IowaScaledEngineering/mss-xcade/README.md

# mss-xcade
Modular Signal System 4 Port Complex Cascade
