IowaScaledEngineering/mss-xcade/kicad/mss-xcade/mss-xcade.ods

Item | Qty | Value | Unit Cost | Ttl Cost | Reference(s) | Description | Device | Digi-Key_PN | Family | MPN | Manufacturer | Status | Voltage
1 | 28 | 0.1uF |  | 0 | C1, C9, C11, C13, C17, C18, C19, C20, C21, C22, C23, C24, C25, C26, C27, C28, C29, C30, C31, C32, C33, C34, C35, C36, C37, C38, C39, C40 |  |  |  |  |  |  |  | 16V
2 | 3 | 1uF |  | 0 | C2, C8, C10 |  |  |  |  |  |  |  | 6.3V
3 | 4 | 22uF |  | 0 | C3, C4, C5, C15 |  |  |  |  |  |  |  | 6.3V
4 | 1 | 68uF |  | 0 | C6
5 | 4 | 10uF |  | 0 | C7, C12, C14, C16 |  |  |  |  |  |  |  | 25V
6 | 5 | CDBM140G | 0.07 | 0.35 | D1, D2, D5, D6, D8
7 | 3 | GREEN LED | 0.05 | 0.15 | D3, D4, D12
8 | 2 | AMBER | 0.05 | 0.1 | D7, D10
9 | 1 | WS2812B | 0.25 | 0.25 | D9
10 | 1 | CDBM140G | 0.07 | 0.07 | D11
12 | 1 | Screw_Terminal_01x02 |  | 0 | J1
13 | 12 | Screw_Terminal_01x02 |  | 0 | J2, J3, J4, J5, J6, J7, J8, J9, J10, J12, J13, J14
14 | 1 | 690-005-299-043 | 0.4 | 0.4 | J11 | CONN RCPT USB2.0 MINI B SMD R/A |  | 151-1206-1-ND | USB, DVI, HDMI Connectors | 690-005-299-043 | EDAC Inc. | Active
15 | 13 | SM04B-SRSS | 0.12 | 1.56 | J15, J16, J17, J18, J19, J20, J21, J22, J23, J24, J25, J26, J27
16 | 1 | Screw_Terminal_01x08 |  | 0 | J28
17 | 4 | 8P8C |  | 0 | J29, J30, J31, J32
18 | 24 | SolderJumper_2_Open |  | 0 | JP1, JP2, JP3, JP4, JP5, JP6, JP7, JP8, JP9, JP10, JP11, JP12, JP13, JP14, JP15, JP16, JP17, JP18, JP19, JP20, JP21, JP22, JP23, JP24
19 | 4 | SolderJumper_2_Bridged |  | 0 | JP25, JP26, JP27, JP28
20 | 2 | 4.7uH | 0.775 | 1.55 | L1, L2 |  | MSS6132-472
21 | 2 | BSS138 | 0.06 | 0.12 | Q1, Q2
22 | 16 | ZXMS6004FF | 0.31 | 4.96 | Q3, Q4, Q5, Q6, Q7, Q8, Q9, Q10, Q11, Q12, Q13, Q14, Q15, Q16, Q17, Q18
23 | 25 | 330 | 0.01 | 0.25 | R1, R4, R5, R6, R7, R8, R9, R11, R14, R19, R20, R22, R23, R24, R25, R26, R27, R28, R29, R30, R31, R32, R33, R35, R51
24 | 15 | 1k | 0.01 | 0.15 | R2, R3, R12, R13, R15, R16, R21, R34, R36, R39, R46, R54, R55, R56, R57
25 | 37 | 10k | 0.01 | 0.37 | R10, R17, R18, R37, R38, R40, R41, R42, R43, R44, R45, R47, R48, R49, R50, R52, R53, R58, R59, R60, R61, R62, R63, R64, R65, R66, R67, R68, R69, R70, R71, R72, R73, R74, R75, R76, R77
26 | 1 | FSM4JSMATR | 0.22 | 0.22 | SW1 | SWITCH TACTILE SPST-NO 0.05A 24V |  | 450-1759-1-ND | Tactile Switches | FSM4JSMATR | TE Connectivity ALCOSWITCH Switches | Active
27 | 2 | SW_DIP_x08 |  | 0 | SW2, SW3
29 | 1 | AZ1117-3.3 | 0.21 | 0.21 | U1
30 | 1 | AP63205WU | 0.58 | 0.58 | U2
31 | 2 | PCA9635 | 2.09 | 4.18 | U3, U6
32 | 1 | ESP32-S2-SOLO | 2.6 | 2.6 | U4
33 | 1 | PCA9548APW | 0.9 | 0.9 | U5
34 | 3 | PCA9555D | 1.15 | 3.45 | U7, U13, U16
35 | 1 | R05C1TF05S-R | 1.83 | 1.83 | U8
36 | 1 | AP3012 | 0.26 | 0.26 | U9
37 | 4 | 74HC4049 | 0.27 | 1.08 | U10, U11, U14, U15
38 | 1 | ISO1641 | 2.32 | 2.32 | U12
 |  |  |  | 27.91
Option B
 | 1 | attiny88 | 1.08 | 1.08
 | 2 | 74HC4049 | 0.27 | 0.54
 | 1 | AP63205WU | 0.58 | 0.58
 | 4 | DPDT signal relay | 1.43 | 5.72
 |  |  |  | 7.92
