IowaScaledEngineering/mss-xcade/pg/mss-xcade-v1.1-e1d36c9/mss-xcade.pdf

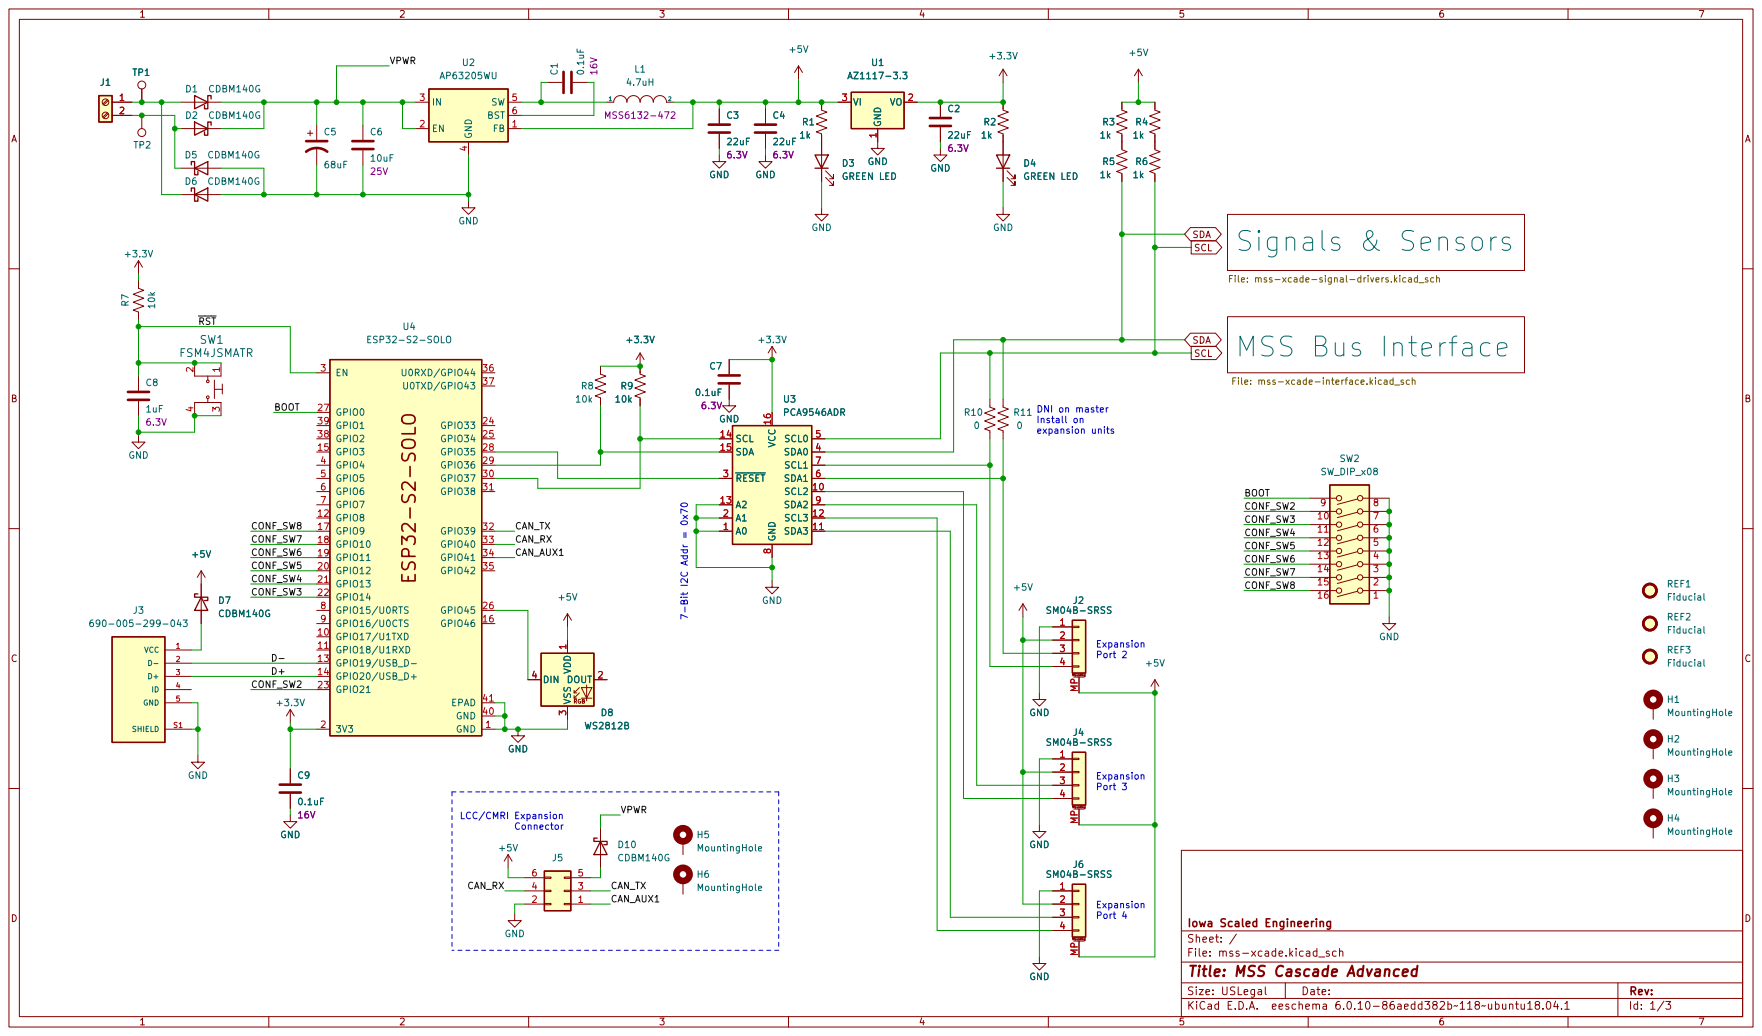
[picture p1: page 1]

File: mss-xcade-signal-drivers.kicad_sch R6

File: mss-xcade-interface.kicad_sch Signals & Sensors

Install on expansion units

VPWR

Iowa Scaled Engineering
File: mss-xcade.kicad_sch Sheet: /
Id: 1/3 Title: MSS Cascade Advanced

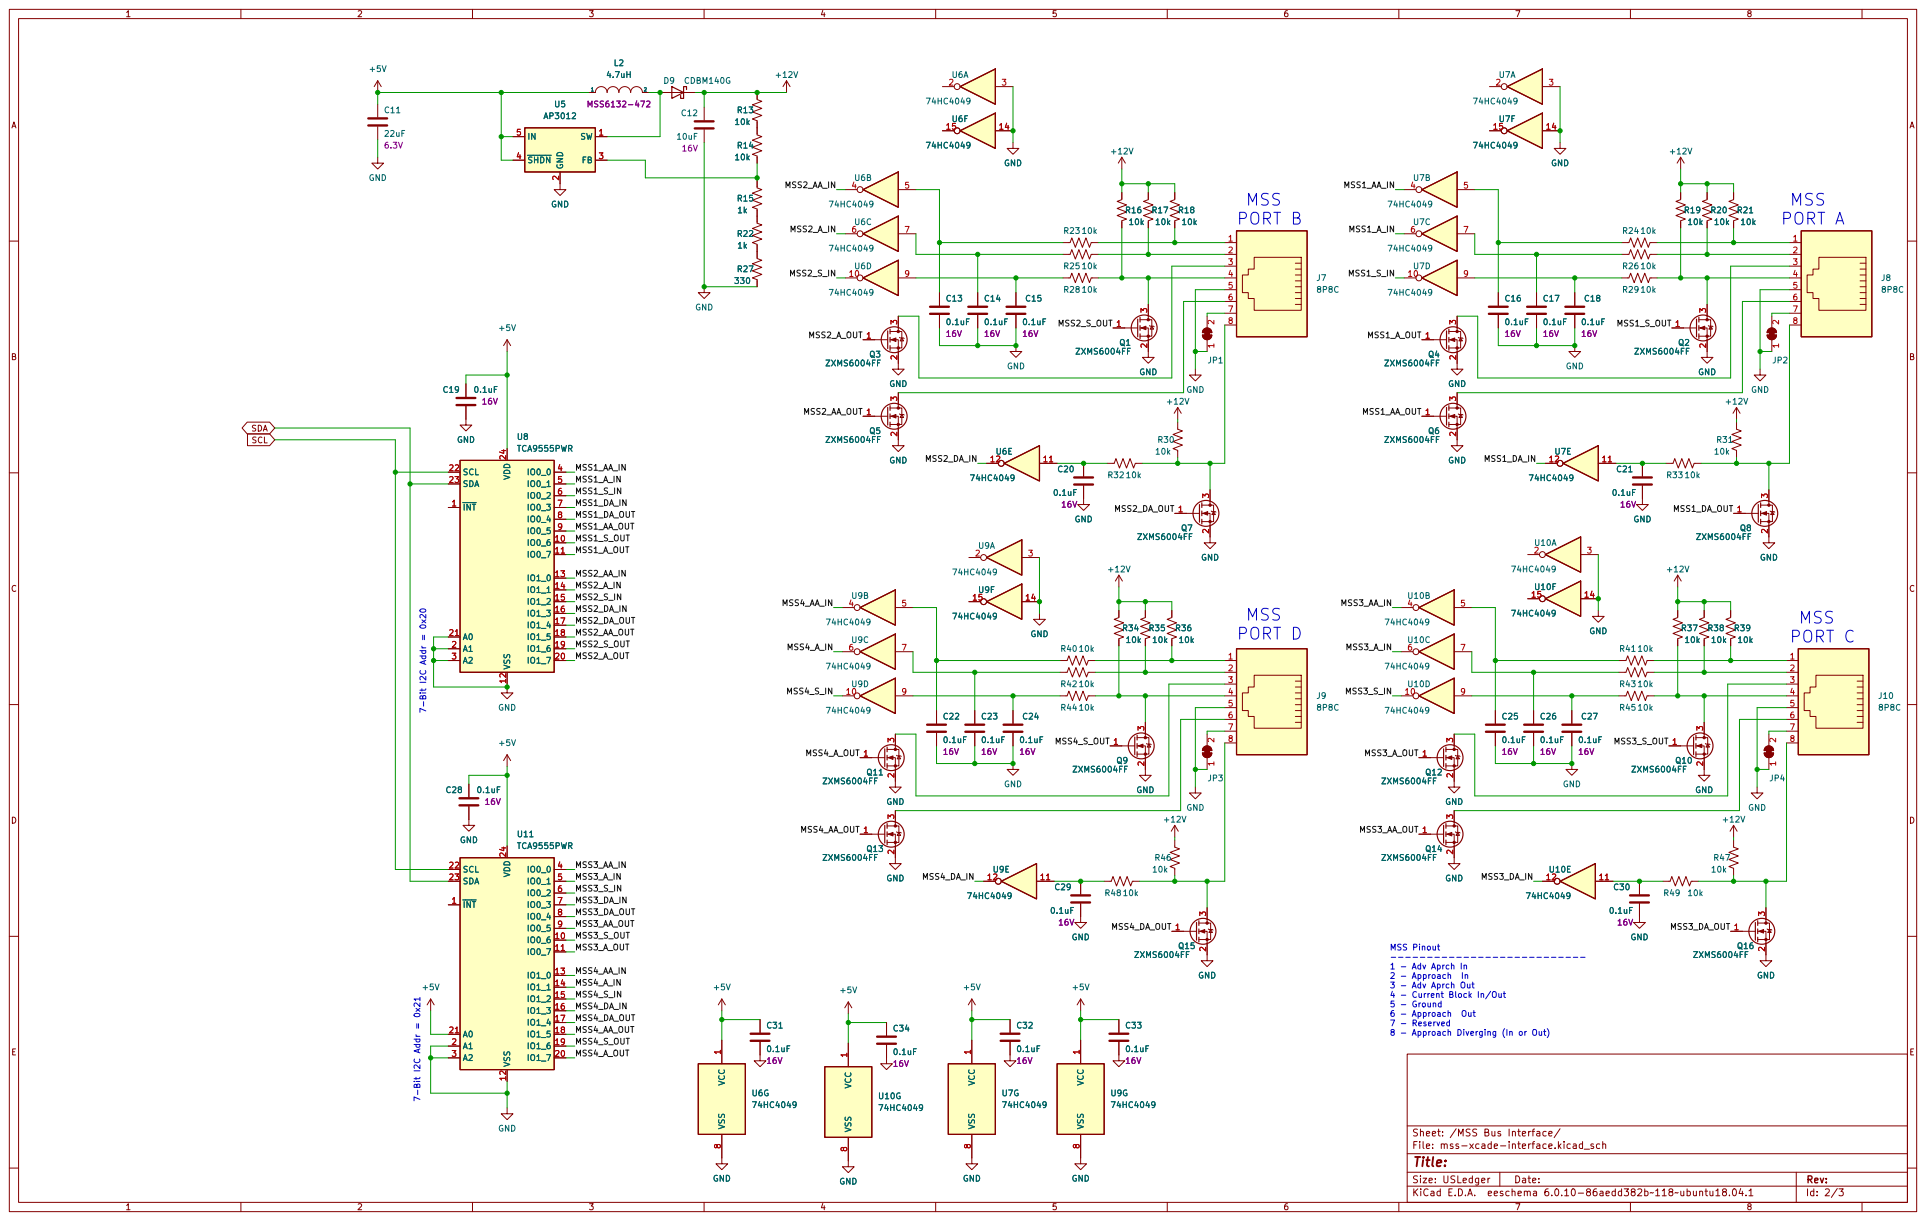
[picture p2: page 2]

MSS Pinout --------------------------- 1 - Adv Aprch In

2 - Approach In
3 - Adv Aprch Out 4 - Current Block In/Out 5 - Ground

8 - Approach Diverging (In or Out)

File: mss-xcade-interface.kicad_sch Sheet: /MSS Bus Interface/

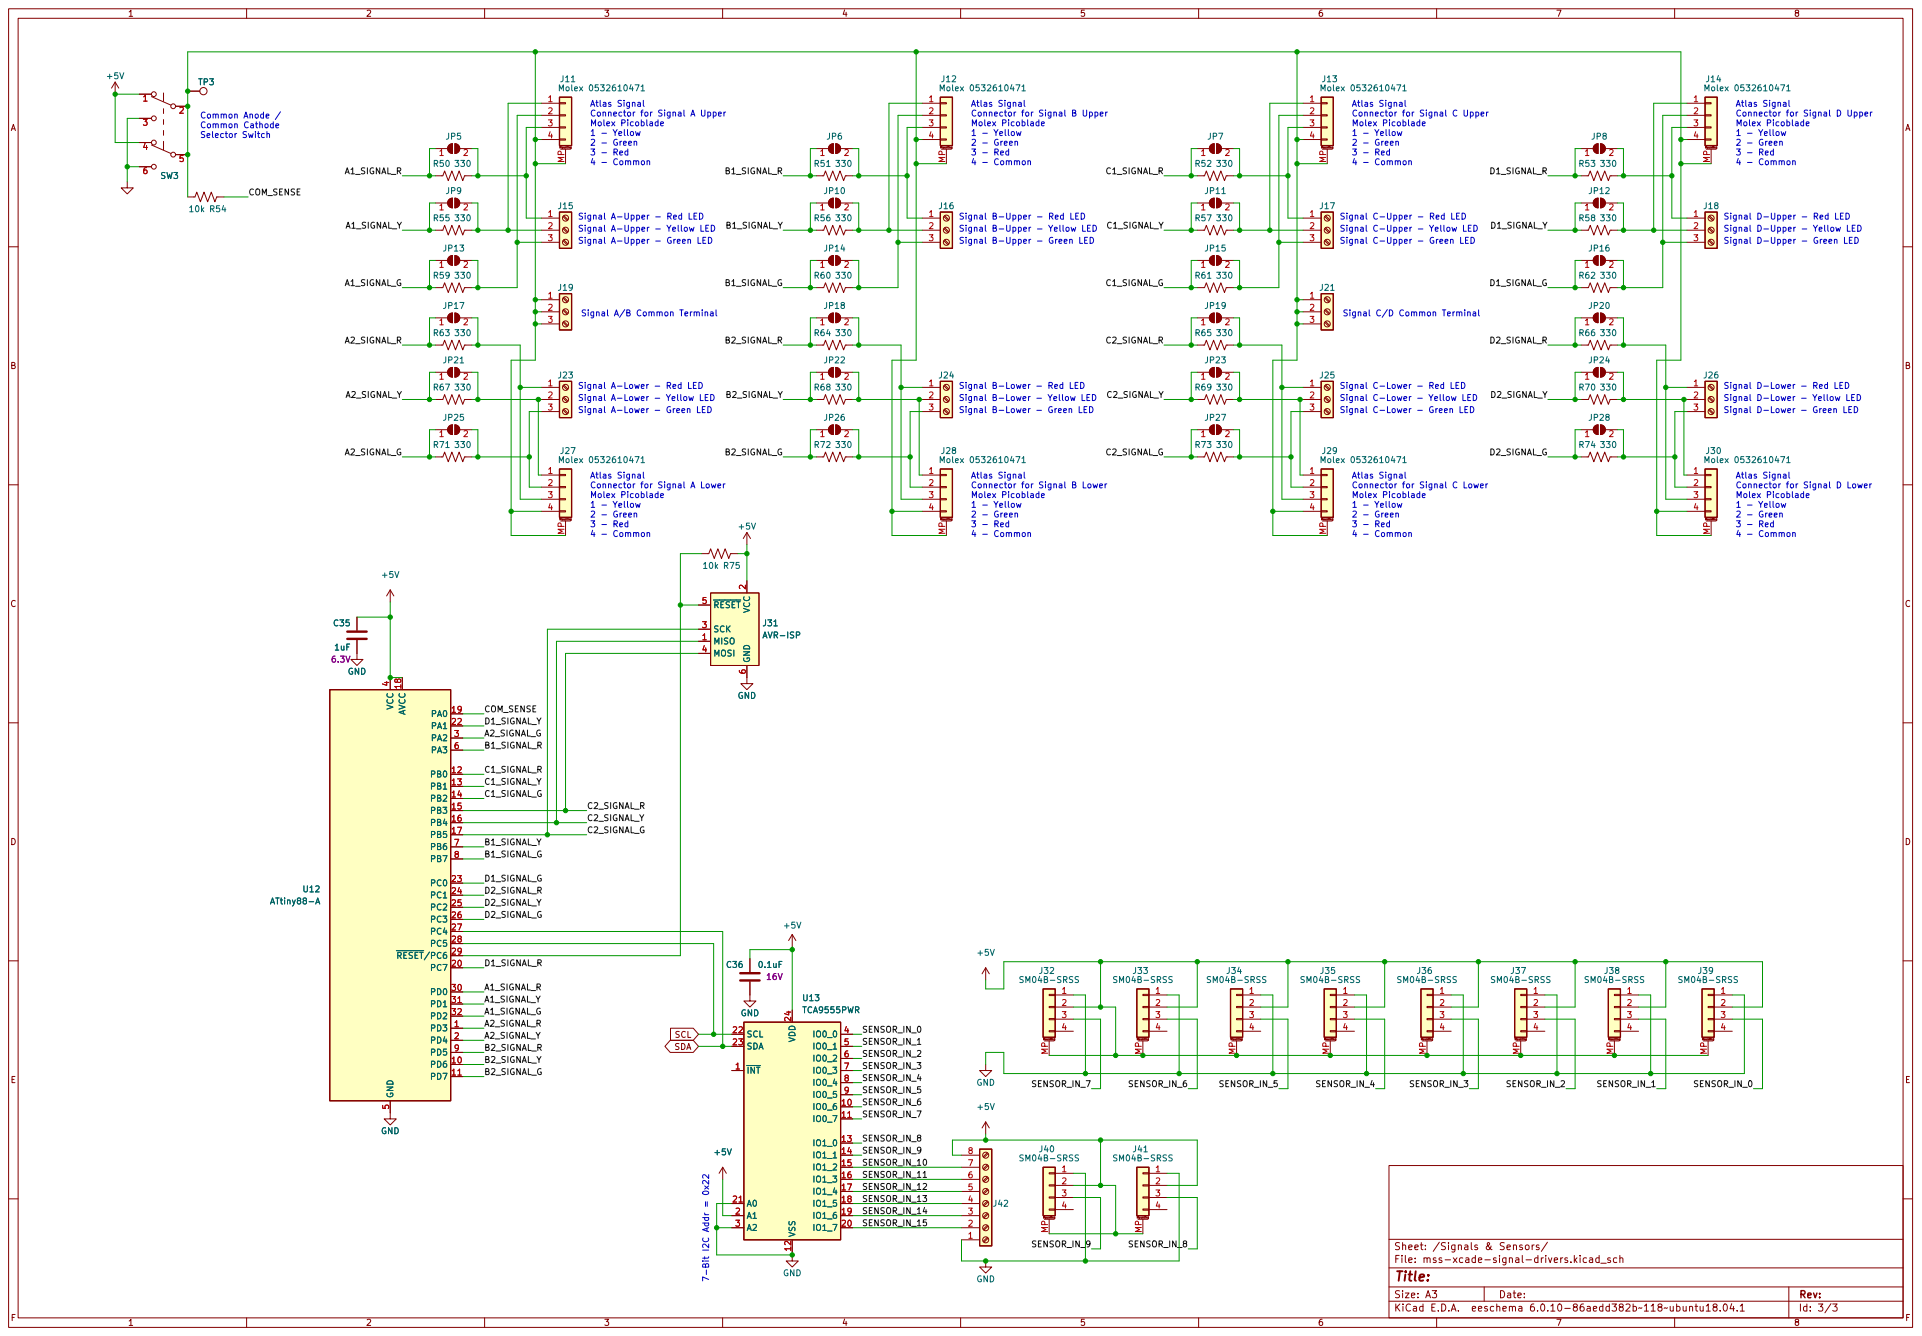
[picture p3: page 3]

Atlas Signal
Connector for Signal A Upper Molex Picoblade

Connector for Signal B Upper Molex Picoblade

Connector for Signal C Upper Molex Picoblade

Connector for Signal D Upper Molex Picoblade

1 - Yellow
2 - Green
3 - Red
4 - Common Signal C-Upper - Green LED

4 - Common Signal D-Upper - Red LED

Signal D-Lower - Red LED 7-Bit I2C Addr = 0x22

Connector for Signal B Lower Molex Picoblade

Connector for Signal C Lower Molex Picoblade

Connector for Signal D Lower Molex Picoblade

Connector for Signal A Lower Molex Picoblade

2 SCK 3 MOSI 4 ~{RESET} 5 GND

Sheet: /Signals & Sensors/
File: mss-xcade-signal-drivers.kicad_sch
Id: 3/3 Title:
