IowaScaledEngineering/mss-xcade/pg/mss-xcade-can-v1.0-1d90998/mss-xcade-can.pdf

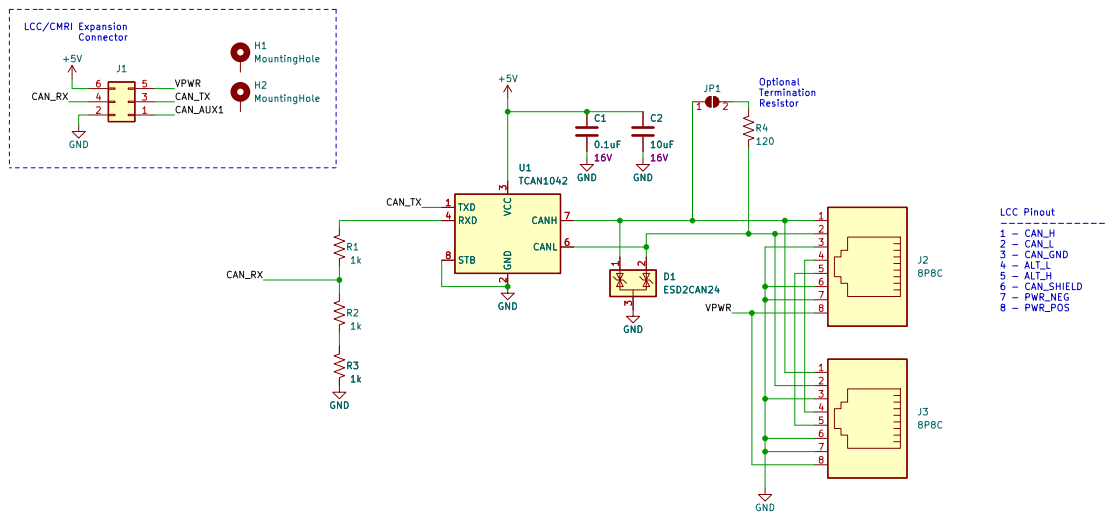
[picture p4: page 1]

3 RXD 4 CANL 6 CANH 7 STB 8 C1

3 RXD 4 CANL 6 CANH 7 STB 8 U1TCAN1042 GND

Iowa Scaled Engineering
File: mss-xcade-can.kicad_sch Sheet: /
Id: 1/1 Title: MSS Cascade Advanced CAN Board
