IowaScaledEngineering/mss-xcade/kicad/mss-xcade/mss-xcade.kicad_pcb

## KiCad design kicad/mss-xcade/mss-xcade.kicad_pcb (2025-08-19)

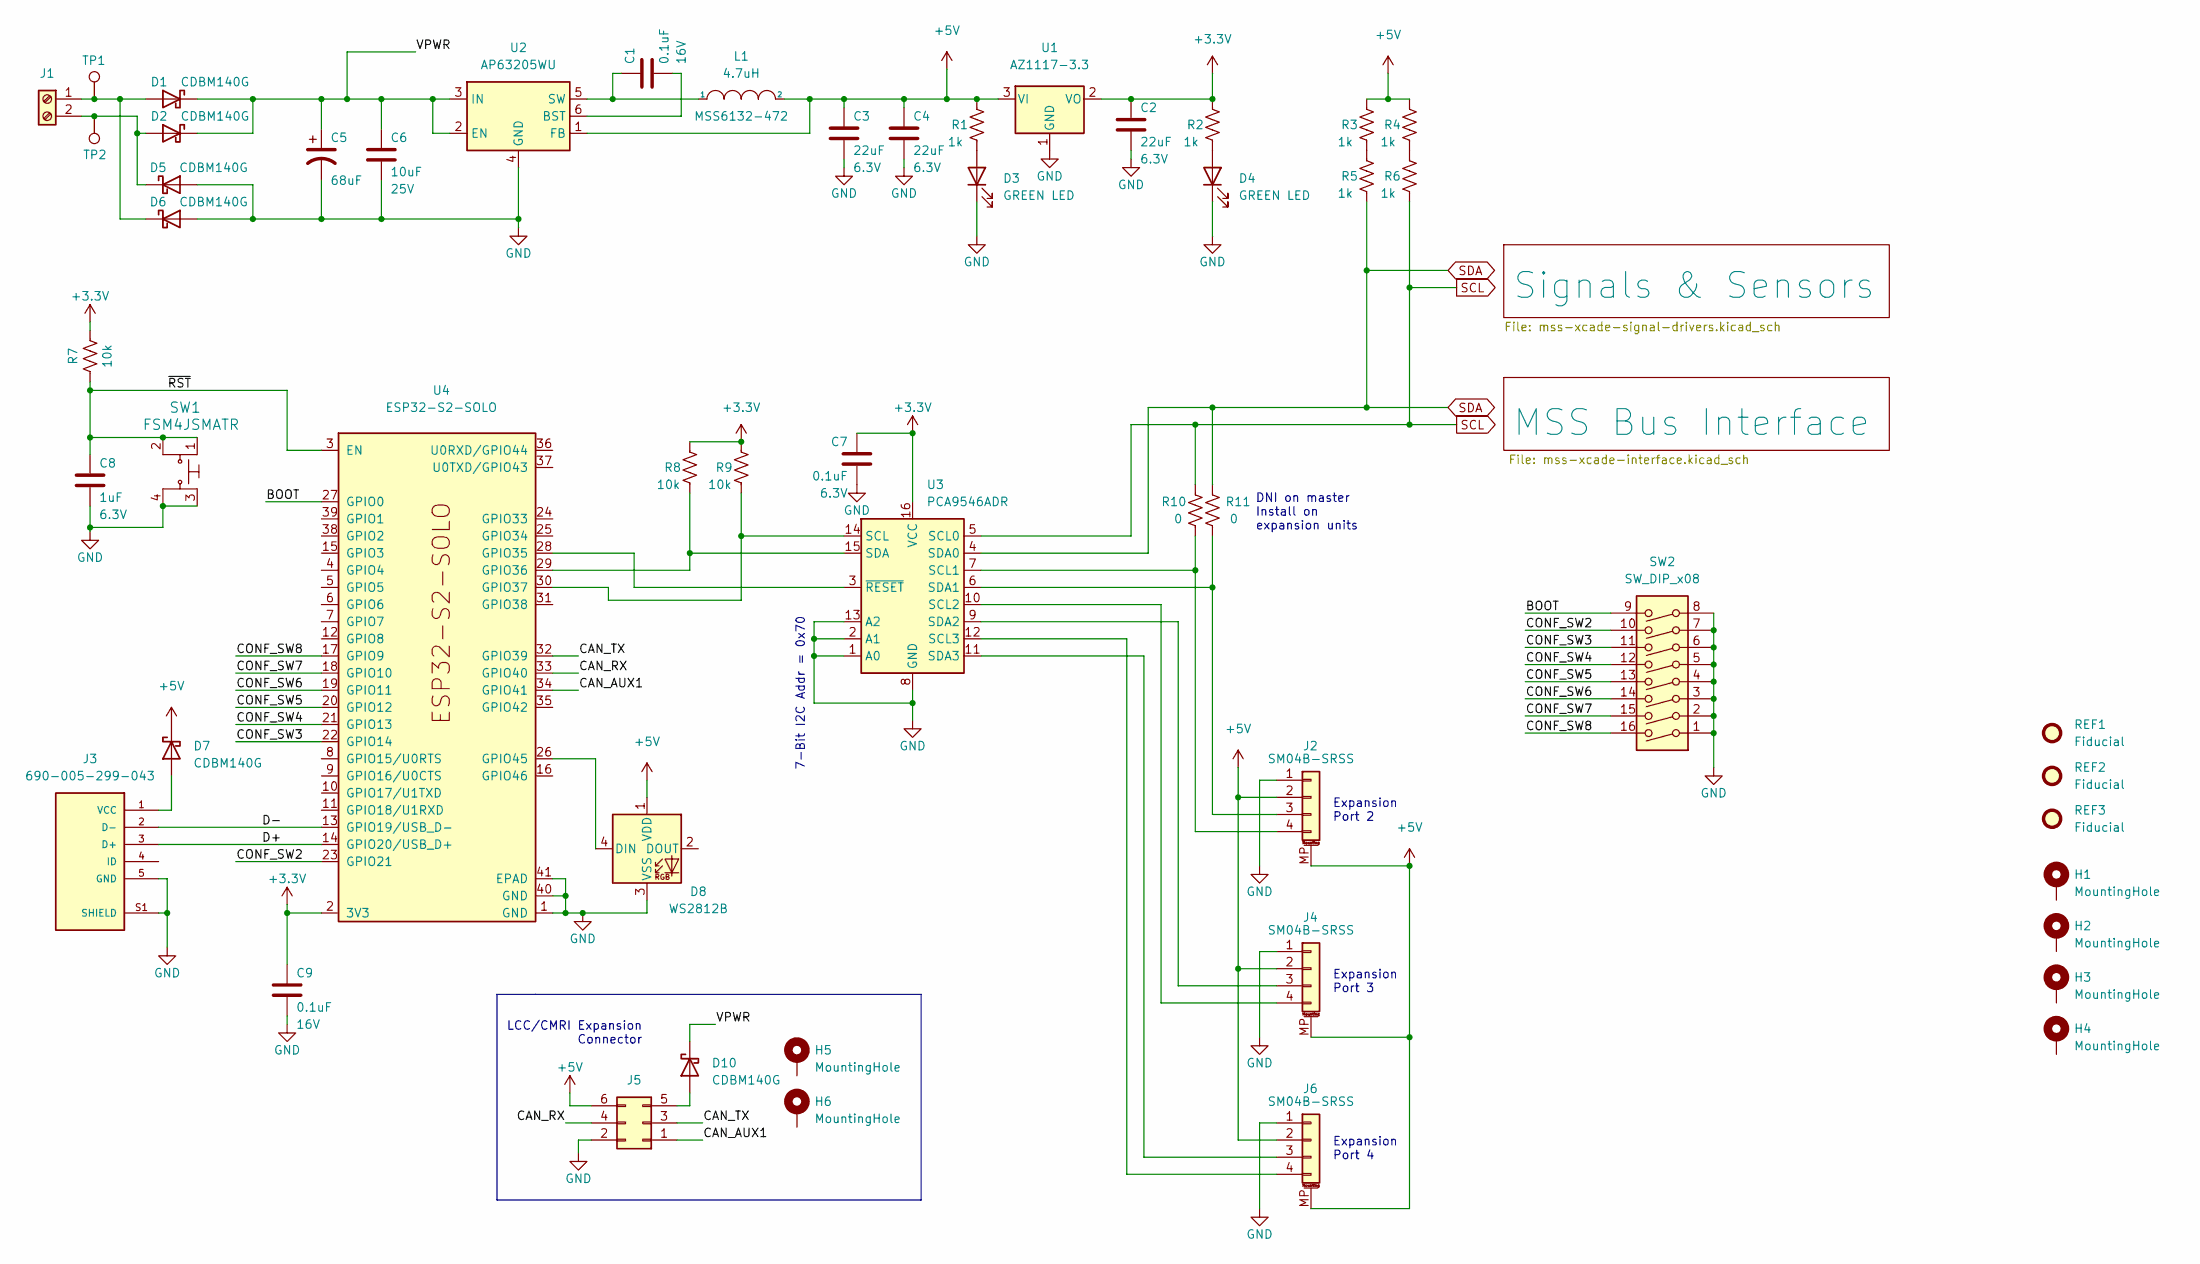
[picture p5: schematic mss-xcade.kicad_sch, MSS Cascade Advanced]

Parts:
C1, C9: 0.1uF; C_0805_2012Metric; Voltage 16V
C2, C3, C4: 22uF; C_0805_2012Metric; Voltage 6.3V
C5: 68uF; CP_Elec_6.3x5.8
C6: 10uF; C_0805_2012Metric; Voltage 25V
C7: 0.1uF; C_0805_2012Metric; Voltage 6.3V
C8: 1uF; C_0805_2012Metric; Voltage 6.3V
D1, D2, D5, D6, D7, D10: CDBM140G; SOD-123T
D3, D4: GREEN LED; LED_0805_2012Metric
D8: WS2812B; LED_WS2812B_PLCC4_5.0x5.0mm_P3.2mm
H1, H2, H3, H4: MountingHole; MountingHole_3.2mm_M3_Pad
H5, H6: MountingHole; MountingHole_3.2mm_M3_ISO14580_Pad
J1: Screw_Terminal_01x02; TerminalBlock_RND_205-00012_1x02_P5.00mm_Horizontal
J2, J4, J6: SM04B-SRSS; JST_SH_SM04B-SRSS-TB_1x04-1MP_P1.00mm_Horizontal
J3: 690-005-299-043; EDAC_690-005-299-043; PARTREV 11
J5: Conn_02x03_Odd_Even; PinHeader_2x03_P2.54mm_Vertical
L1: 4.7uH; MSS6132-xxxMLC
R1, R2, R3, R4, R5, R6: 1k; R_0805_2012Metric
R7, R8, R9: 10k; R_0805_2012Metric
R10, R11: 0; R_0805_2012Metric
REF1, REF2, REF3: Fiducial
SW1: FSM4JSMATR; TE_FSM4JSMA; MPN FSM4JSMATR; Digi-Key_PN 450-1759-1-ND
SW2: SW_DIP_x08; SW_DIP_SPSTx08_Slide_6.7x21.88mm_W8.61mm_P2.54mm_LowProfile
TP1, TP2: TestPoint; TestPoint_Pad_D2.0mm
U1: AZ1117-3.3; SOT-223-3_TabPin2
U2: AP63205WU; TSOT-23-6
U3: PCA9546ADR; SOIC-16_3.9x9.9mm_P1.27mm
U4: ESP32-S2-SOLO

Connections:
+3.3V: C2.1, C7.1, C9.1, R2.2, R7.2, R8.2, R9.2, U1.2 (VO), U3.16 (VCC), U4.2 (3V3)
+5V: C3.1, C4.1, D7.1 (K), D8.1 (VDD), J2.2, J2.MP (MountPin), J4.2, J4.MP (MountPin), J5.6, J6.2, J6.MP (MountPin), L1.2, R1.2, R3.2, R4.2, U1.3 (VI), U2.1 (FB); also elsewhere on the board
/BOOT: SW2.9, U4.27 (GPIO0)
/CAN_AUX1: J5.1, U4.34 (GPIO41)
/CAN_RX: J5.4, U4.33 (GPIO40)
/CAN_TX: J5.3, U4.32 (GPIO39)
/CONF_SW2: SW2.10, U4.23 (GPIO21)
/CONF_SW3: SW2.11, U4.22 (GPIO14)
/CONF_SW4: SW2.12, U4.21 (GPIO13)
/CONF_SW5: SW2.13, U4.20 (GPIO12)
/CONF_SW6: SW2.14, U4.19 (GPIO11)
/CONF_SW7: SW2.15, U4.18 (GPIO10)
/CONF_SW8: SW2.16, U4.17 (GPIO9)
/D+: J3.3 (D+), U4.14 (GPIO20/USB_D+)
/D-: J3.2 (D-), U4.13 (GPIO19/USB_D-)
/VPWR: C5.1, C6.1, D1.1 (K), D2.1 (K), D10.1 (K), U2.2 (EN), U2.3 (IN)
/~RST: C8.1, R7.1, SW1.1, SW1.2, U4.3 (EN)
GND: C2.2, C3.2, C4.2, C5.2, C6.2, C7.2, C8.2, C9.2, D3.1 (K), D4.1 (K), D5.2 (A), D6.2 (A), D8.3 (VSS), J2.1, J3.5 (GND), J3.S1 (SHIELD), J4.1, J5.2, J6.1, SW1.3, SW1.4, SW2.1, SW2.2, SW2.3, SW2.4, SW2.5, SW2.6, SW2.7, SW2.8, U1.1 (GND), U2.4 (GND), U3.1 (A0), U3.2 (A1), U3.8 (GND), U3.13 (A2), U4.1 (GND), U4.40 (GND), U4.41 (EPAD); also elsewhere on the board
unnamed: C1.1, L1.1, U2.5 (SW)
unnamed: C1.2, U2.6 (BST)
unnamed: D1.2 (A), D6.1 (K), J1.1, TP1.1
unnamed: D2.2 (A), D5.1 (K), J1.2, TP2.1
unnamed: D3.2 (A), R1.1
unnamed: D4.2 (A), R2.1
unnamed: D7.2 (A), J3.1 (VCC)
unnamed: D8.4 (DIN), U4.26 (GPIO45)
unnamed: D10.2 (A), J5.5
unnamed: J2.3, R11.1, U3.6 (SDA1)
unnamed: J2.4, R10.1, U3.7 (SCL1)
unnamed: J4.3, U3.9 (SDA2)
unnamed: J4.4, U3.10 (SCL2)
unnamed: J6.3, U3.11 (SDA3)
unnamed: J6.4, U3.12 (SCL3)
unnamed: R3.1, R5.2
unnamed: R4.1, R6.2
unnamed: R8.1, U3.15 (SDA), U4.29 (GPIO36)
unnamed: R9.1, U3.14 (SCL), U4.30 (GPIO37)
unnamed: U3.3 (~RESET), U4.28 (GPIO35)
SCL: R6.1, R10.2, U3.5 (SCL0); also elsewhere on the board
SDA: R5.1, R11.2, U3.4 (SDA0); also elsewhere on the board

Notes on the sheet:
LCC/CMRI Expansion Connector
Expansion Port 2
Expansion Port 4
DNI on master Install on expansion units
7-Bit I2C Addr = 0x70
Expansion Port 3

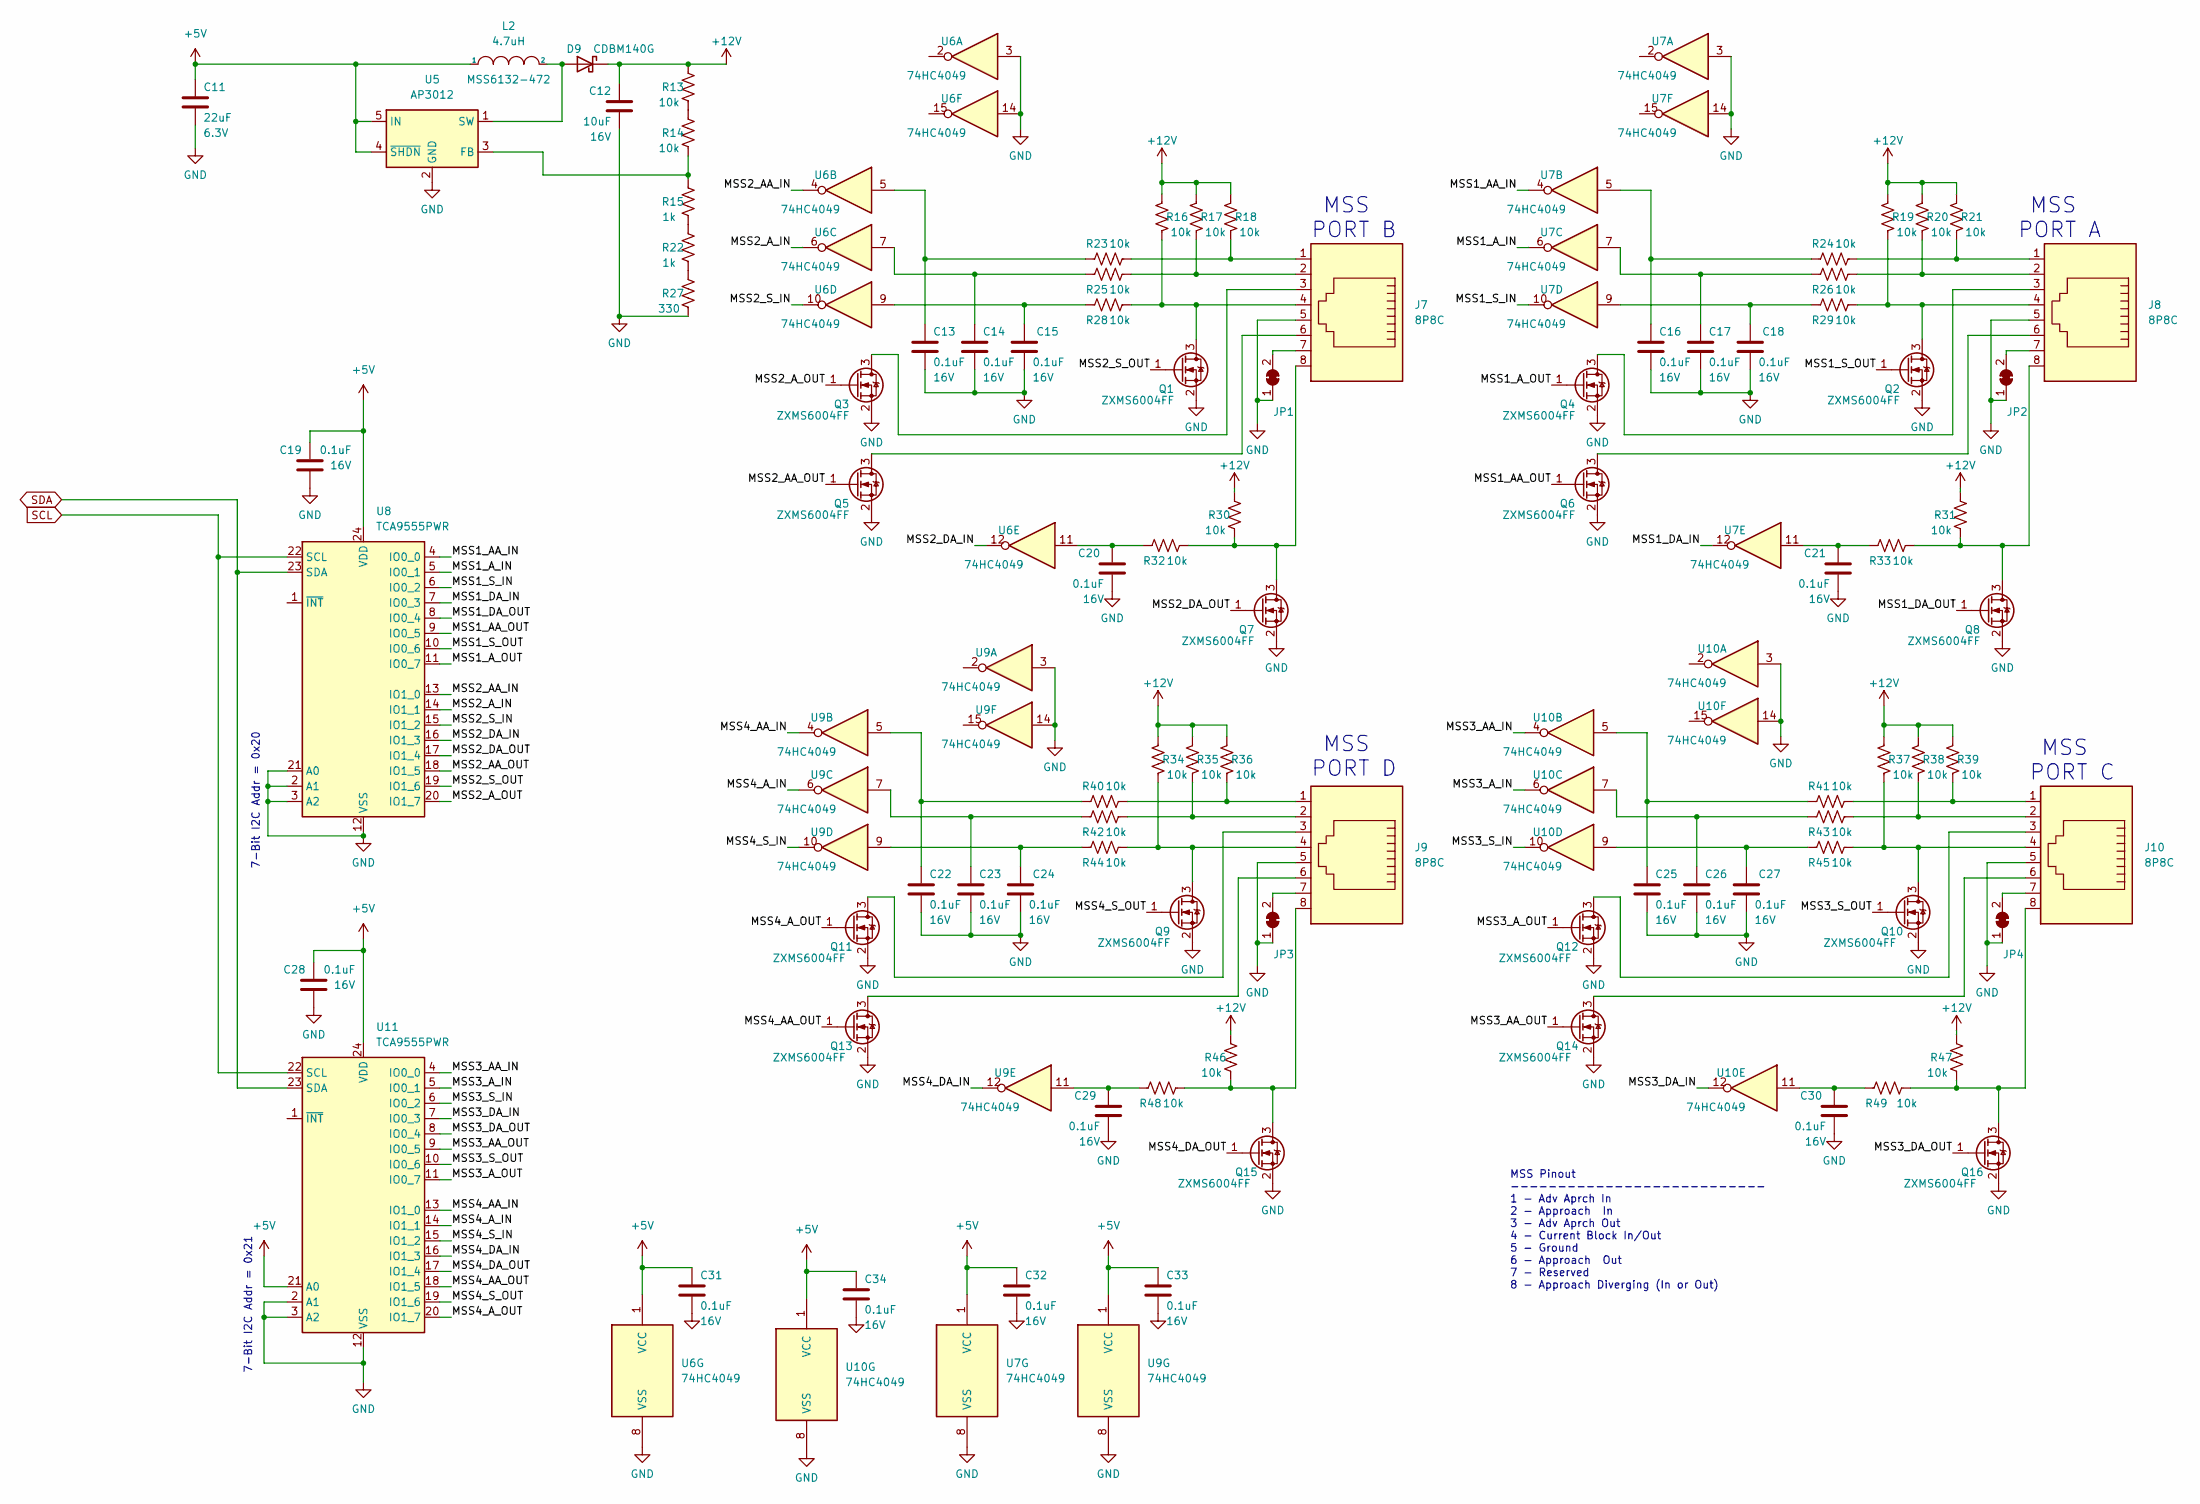
[picture p6: schematic mss-xcade-interface.kicad_sch]

Parts:
C11: 22uF; C_0805_2012Metric; Voltage 6.3V
C12: 10uF; C_0805_2012Metric; Voltage 16V
C13, C14, C15, C16, C17, C18, C19, C20, C21, C22, C23, C24, C25, C26, C27, C28, C29, C30, C31, C32, C33, C34: 0.1uF; C_0805_2012Metric; Voltage 16V
D9: CDBM140G; SOD-123T
J7, J8, J9, J10: 8P8C; RJ45_Amphenol_54602-x08_Horizontal
JP1, JP2, JP3, JP4: SolderJumper_2_Bridged; SolderJumper-2_P1.3mm_Bridged_RoundedPad1.0x1.5mm
L2: 4.7uH; MSS6132-xxxMLC
Q1, Q2, Q3, Q4, Q5, Q6, Q7, Q8, Q9, Q10, Q11, Q12, Q13, Q14, Q15, Q16: ZXMS6004FF; SOT-23
R13, R14, R16, R17, R18, R19, R20, R21, R23, R24, R25, R26, R28, R29, R30, R31, R32, R33, R34, R35, R36, R37, R38, R39, R40, R41, R42, R43, R44, R45, R46, R47, R48, R49: 10k; R_0805_2012Metric
R15, R22: 1k; R_0805_2012Metric
R27: 330; R_0805_2012Metric
U5: AP3012; SOT-23-5
U6, U7, U9, U10: 74HC4049; SO-16_3.9x9.9mm_P1.27mm
U8, U11: TCA9555PWR; TSSOP-24_4.4x7.8mm_P0.65mm

Connections:
+5V: C11.1, C19.1, C28.1, C31.1, C32.1, C33.1, C34.1, L2.1, U5.4 (~SHDN), U5.5 (IN), U6.1 (VCC), U7.1 (VCC), U8.24 (VDD), U9.1 (VCC), U10.1 (VCC), U11.21 (A0), U11.24 (VDD); also elsewhere on the board
+12V: C12.1, D9.1 (K), R13.2, R16.2, R17.2, R18.2, R19.2, R20.2, R21.2, R30.2, R31.2, R34.2, R35.2, R36.2, R37.2, R38.2, R39.2, R46.2, R47.2
/MSS Bus Interface/MSS1_AA_IN: U7.4, U8.4 (IO0_0)
/MSS Bus Interface/MSS1_AA_OUT: Q6.1 (G), U8.9 (IO0_5)
/MSS Bus Interface/MSS1_A_IN: U7.6, U8.5 (IO0_1)
/MSS Bus Interface/MSS1_A_OUT: Q4.1 (G), U8.11 (IO0_7)
/MSS Bus Interface/MSS1_DA_IN: U7.12, U8.7 (IO0_3)
/MSS Bus Interface/MSS1_DA_OUT: Q8.1 (G), U8.8 (IO0_4)
/MSS Bus Interface/MSS1_S_IN: U7.10, U8.6 (IO0_2)
/MSS Bus Interface/MSS1_S_OUT: Q2.1 (G), U8.10 (IO0_6)
/MSS Bus Interface/MSS2_AA_IN: U6.4, U8.13 (IO1_0)
/MSS Bus Interface/MSS2_AA_OUT: Q5.1 (G), U8.18 (IO1_5)
/MSS Bus Interface/MSS2_A_IN: U6.6, U8.14 (IO1_1)
/MSS Bus Interface/MSS2_A_OUT: Q3.1 (G), U8.20 (IO1_7)
/MSS Bus Interface/MSS2_DA_IN: U6.12, U8.16 (IO1_3)
/MSS Bus Interface/MSS2_DA_OUT: Q7.1 (G), U8.17 (IO1_4)
/MSS Bus Interface/MSS2_S_IN: U6.10, U8.15 (IO1_2)
/MSS Bus Interface/MSS2_S_OUT: Q1.1 (G), U8.19 (IO1_6)
/MSS Bus Interface/MSS3_AA_IN: U10.4, U11.4 (IO0_0)
/MSS Bus Interface/MSS3_AA_OUT: Q14.1 (G), U11.9 (IO0_5)
/MSS Bus Interface/MSS3_A_IN: U10.6, U11.5 (IO0_1)
/MSS Bus Interface/MSS3_A_OUT: Q12.1 (G), U11.11 (IO0_7)
/MSS Bus Interface/MSS3_DA_IN: U10.12, U11.7 (IO0_3)
/MSS Bus Interface/MSS3_DA_OUT: Q16.1 (G), U11.8 (IO0_4)
/MSS Bus Interface/MSS3_S_IN: U10.10, U11.6 (IO0_2)
/MSS Bus Interface/MSS3_S_OUT: Q10.1 (G), U11.10 (IO0_6)
/MSS Bus Interface/MSS4_AA_IN: U9.4, U11.13 (IO1_0)
/MSS Bus Interface/MSS4_AA_OUT: Q13.1 (G), U11.18 (IO1_5)
/MSS Bus Interface/MSS4_A_IN: U9.6, U11.14 (IO1_1)
/MSS Bus Interface/MSS4_A_OUT: Q11.1 (G), U11.20 (IO1_7)
/MSS Bus Interface/MSS4_DA_IN: U9.12, U11.16 (IO1_3)
/MSS Bus Interface/MSS4_DA_OUT: Q15.1 (G), U11.17 (IO1_4)
/MSS Bus Interface/MSS4_S_IN: U9.10, U11.15 (IO1_2)
/MSS Bus Interface/MSS4_S_OUT: Q9.1 (G), U11.19 (IO1_6)
GND: C11.2, C12.2, C13.2, C14.2, C15.2, C16.2, C17.2, C18.2, C19.2, C20.2, C21.2, C22.2, C23.2, C24.2, C25.2, C26.2, C27.2, C28.2, C29.2, C30.2, C31.2, C32.2, C33.2, C34.2, J7.5, J8.5, J9.5, J10.5, JP1.1 (A), JP2.1 (A), JP3.1 (A), JP4.1 (A), Q1.2 (S), Q2.2 (S), Q3.2 (S), Q4.2 (S), Q5.2 (S), Q6.2 (S), Q7.2 (S), Q8.2 (S), Q9.2 (S), Q10.2 (S), Q11.2 (S), Q12.2 (S), Q13.2 (S), Q14.2 (S), Q15.2 (S), Q16.2 (S), R27.1, U5.2 (GND), U6.3, U6.8 (VSS), U6.14, U7.3, U7.8 (VSS), U7.14, U8.2 (A1), U8.3 (A2), U8.12 (VSS), U8.21 (A0), U9.3, U9.8 (VSS), U9.14, U10.3, U10.8 (VSS), U10.14, U11.2 (A1), U11.3 (A2), U11.12 (VSS); also elsewhere on the board
unnamed: C13.1, R23.2, U6.5
unnamed: C14.1, R25.2, U6.7
unnamed: C15.1, R28.2, U6.9
unnamed: C16.1, R24.2, U7.5
unnamed: C17.1, R26.2, U7.7
unnamed: C18.1, R29.2, U7.9
unnamed: C20.1, R32.2, U6.11
unnamed: C21.1, R33.2, U7.11
unnamed: C22.1, R40.2, U9.5
unnamed: C23.1, R42.2, U9.7
unnamed: C24.1, R44.2, U9.9
unnamed: C25.1, R41.2, U10.5
unnamed: C26.1, R43.2, U10.7
unnamed: C27.1, R45.2, U10.9
unnamed: C29.1, R48.2, U9.11
unnamed: C30.1, R49.2, U10.11
unnamed: D9.2 (A), L2.2, U5.1 (SW)
unnamed: J7.1, R18.1, R23.1
unnamed: J7.2, R17.1, R25.1
unnamed: J7.3, Q3.3 (D)
unnamed: J7.4, Q1.3 (D), R16.1, R28.1
unnamed: J7.6, Q5.3 (D)
unnamed: J7.7, JP1.2 (B)
unnamed: J7.8, Q7.3 (D), R30.1, R32.1
unnamed: J8.1, R21.1, R24.1
unnamed: J8.2, R20.1, R26.1
unnamed: J8.3, Q4.3 (D)
unnamed: J8.4, Q2.3 (D), R19.1, R29.1
unnamed: J8.6, Q6.3 (D)
unnamed: J8.7, JP2.2 (B)
unnamed: J8.8, Q8.3 (D), R31.1, R33.1
unnamed: J9.1, R36.1, R40.1
unnamed: J9.2, R35.1, R42.1
unnamed: J9.3, Q11.3 (D)
unnamed: J9.4, Q9.3 (D), R34.1, R44.1
unnamed: J9.6, Q13.3 (D)
unnamed: J9.7, JP3.2 (B)
unnamed: J9.8, Q15.3 (D), R46.1, R48.1
unnamed: J10.1, R39.1, R41.1
unnamed: J10.2, R38.1, R43.1
unnamed: J10.3, Q12.3 (D)
unnamed: J10.4, Q10.3 (D), R37.1, R45.1
unnamed: J10.6, Q14.3 (D)
unnamed: J10.7, JP4.2 (B)
unnamed: J10.8, Q16.3 (D), R47.1, R49.1
unnamed: R13.1, R14.2
unnamed: R14.1, R15.2, U5.3 (FB)
unnamed: R15.1, R22.2
unnamed: R22.1, R27.2
SCL: U8.22 (SCL), U11.22 (SCL); also elsewhere on the board
SDA: U8.23 (SDA), U11.23 (SDA); also elsewhere on the board

Notes on the sheet:
MSS PORT A
7-Bit I2C Addr = 0x20
MSS Pinout --------------------------- 1 - Adv Aprch In 2 - Approach In 3 - Adv Aprch Out 4 - Current Block In/Out 5 - Ground 6 - Approach Out 7 - Reserved 8 - Approach Diverging (In or Out)
7-Bit I2C Addr = 0x21
MSS PORT B
MSS PORT D
MSS PORT C

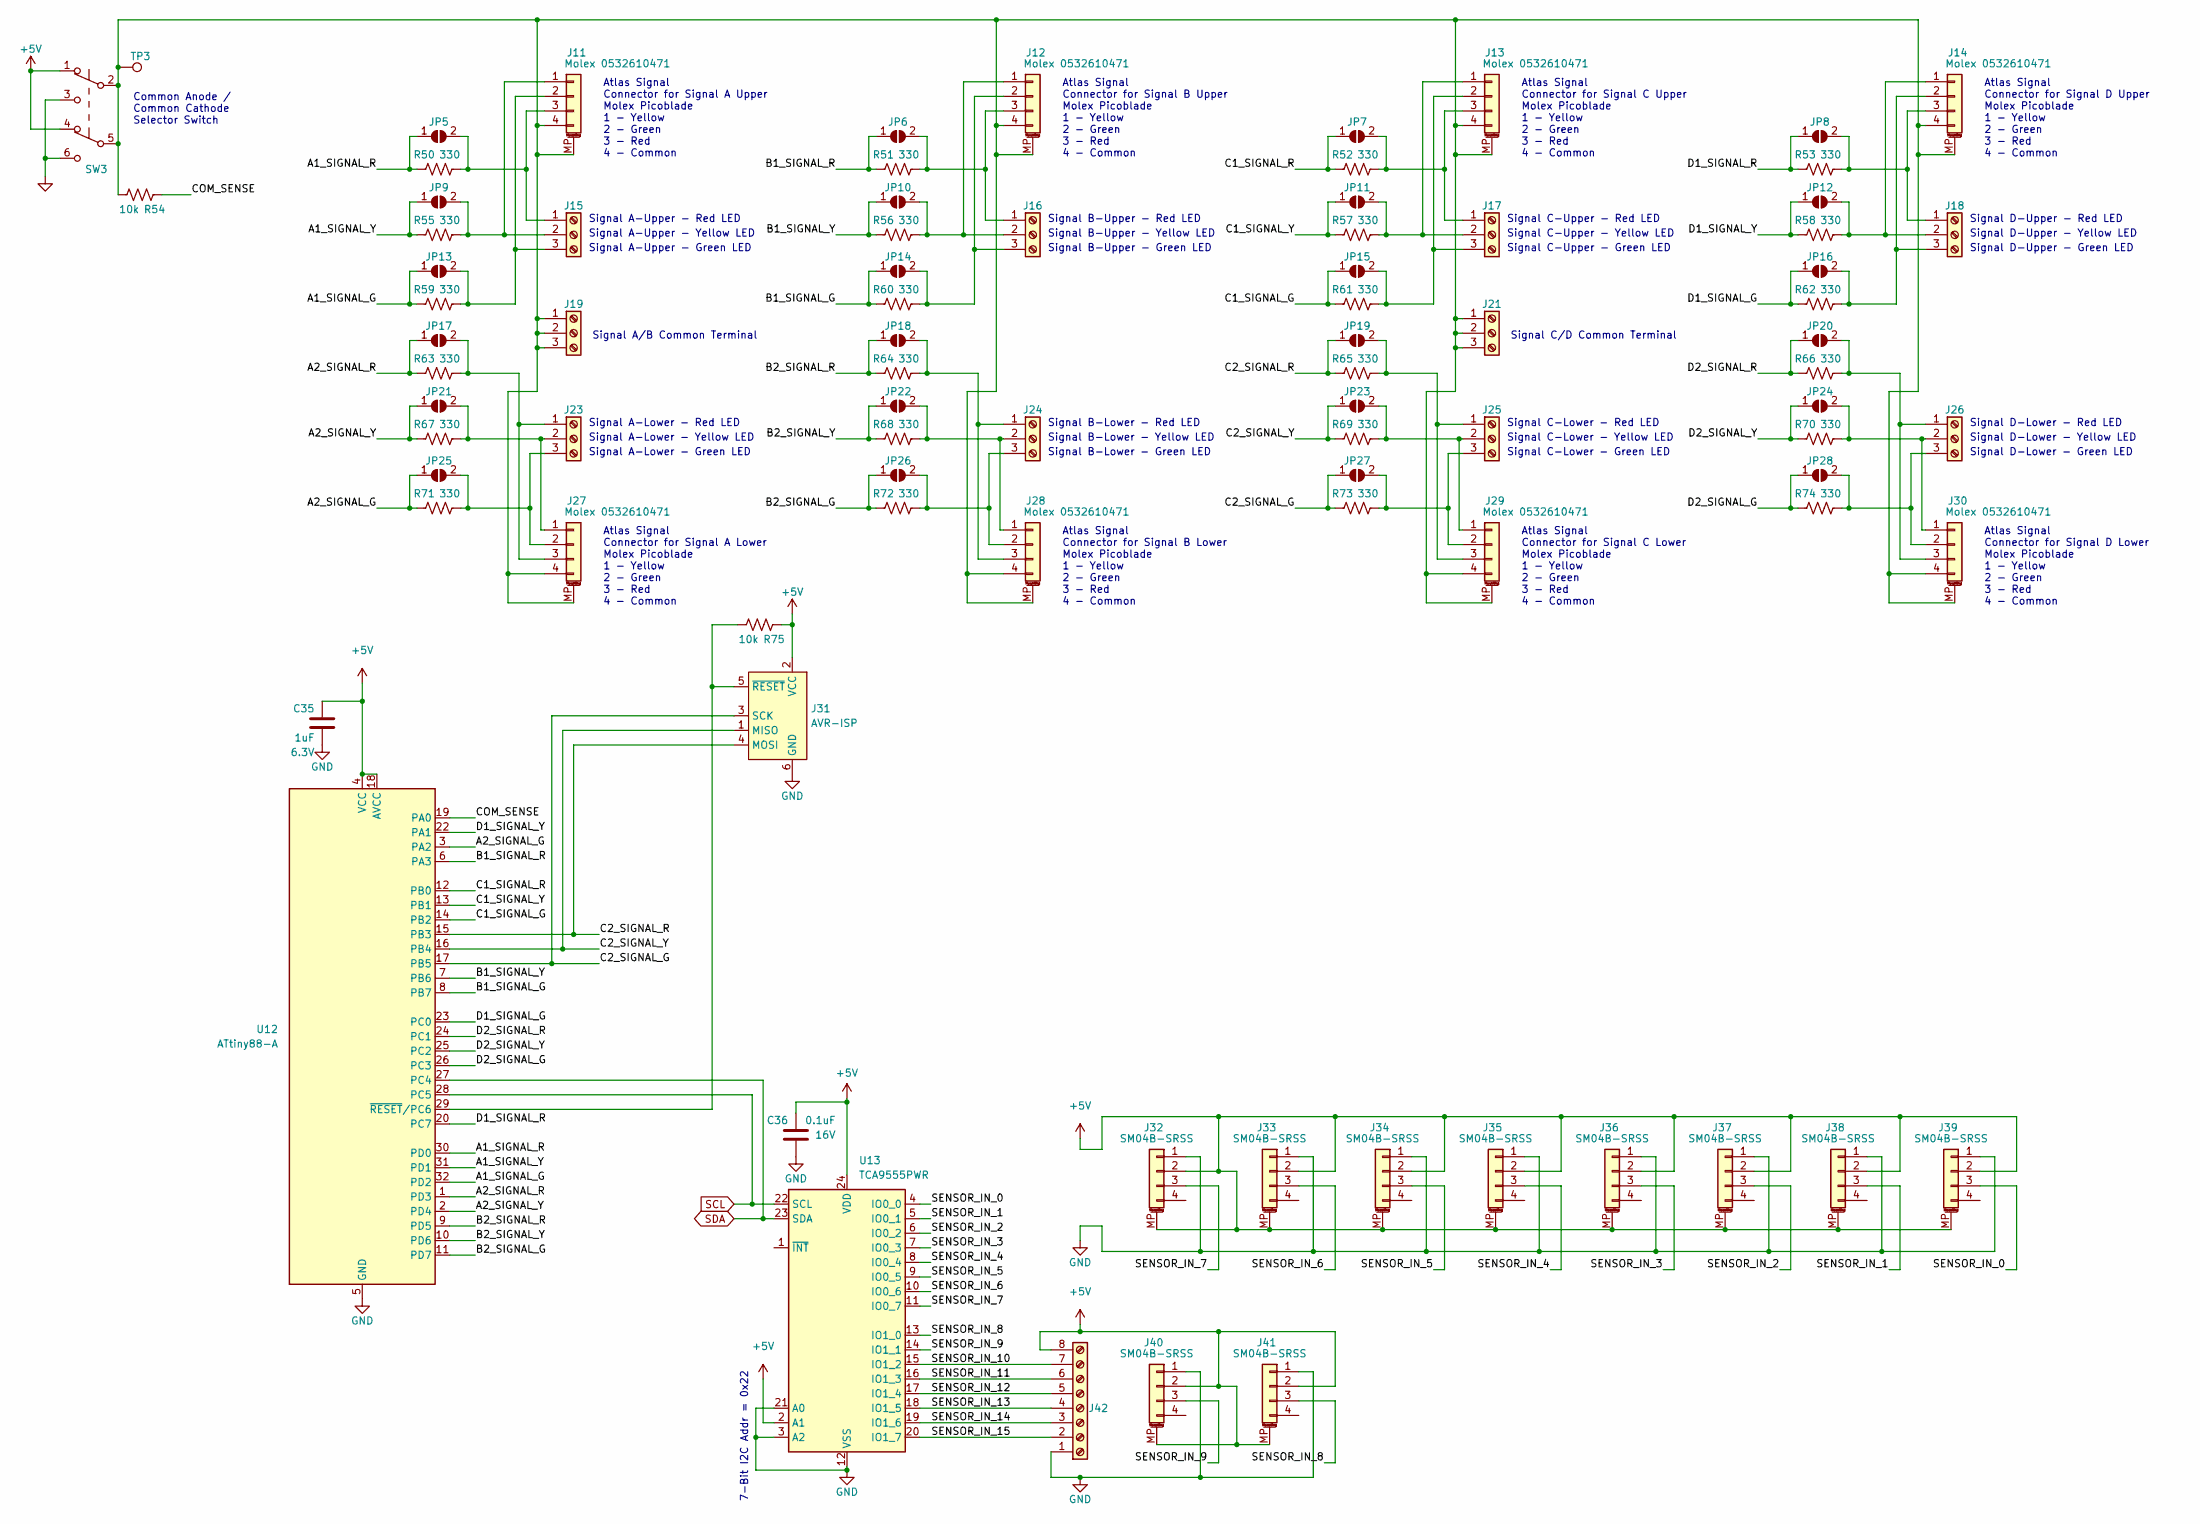
[picture p7: schematic mss-xcade-signal-drivers.kicad_sch]

Parts:
C35: 1uF; C_0805_2012Metric; Voltage 6.3V
C36: 0.1uF; C_0805_2012Metric; Voltage 16V
J11, J12, J13, J14, J27, J28, J29, J30: Molex 0532610471; Molex_PicoBlade_53261-0471_1x04-1MP_P1.25mm_Horizontal
J15, J16, J17, J18, J19, J21, J23, J24, J25, J26: Screw_Terminal_01x02; TerminalBlock_MetzConnect_Type059_RT06303HBWC_1x03_P3.50mm_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
J31: AVR-ISP; Tag-Connect_TC2030-IDC-NL_2x03_P1.27mm_Vertical
J32, J33, J34, J35, J36, J37, J38, J39, J40, J41: SM04B-SRSS; JST_SH_SM04B-SRSS-TB_1x04-1MP_P1.00mm_Horizontal
J42: Screw_Terminal_01x08; TerminalBlock_TE_282834-8_1x08_P2.54mm_Horizontal
JP5, JP6, JP7, JP8, JP9, JP10, JP11, JP12, JP13, JP14, JP15, JP16, JP17, JP18, JP19, JP20, JP21, JP22, JP23, JP24, JP25, JP26, JP27, JP28: SolderJumper_2_Open; SolderJumper-2_P1.3mm_Open_RoundedPad1.0x1.5mm
R50, R51, R52, R53, R55, R56, R57, R58, R59, R60, R61, R62, R63, R64, R65, R66, R67, R68, R69, R70, R71, R72, R73, R74: 330; R_0805_2012Metric
R54, R75: 10k; R_0805_2012Metric
SW3: JS202011SCQN; SW_JS202011SCQN
TP3: TestPoint; TestPoint_Pad_D2.0mm
U12: ATtiny88-A; TQFP-32_7x7mm_P0.8mm
U13: TCA9555PWR; TSSOP-24_4.4x7.8mm_P0.65mm

Connections:
+5V: C35.1, C36.1, J31.2 (VCC), J32.2, J32.MP (MountPin), J33.2, J33.MP (MountPin), J34.2, J34.MP (MountPin), J35.2, J35.MP (MountPin), J36.2, J36.MP (MountPin), J37.2, J37.MP (MountPin), J38.2, J38.MP (MountPin), J39.2, J39.MP (MountPin), J40.2, J40.MP (MountPin), J41.2, J41.MP (MountPin), J42.8, R75.1, SW3.1 (A), SW3.4 (A), U12.4 (VCC), U12.18 (AVCC), U13.2 (A1), U13.24 (VDD); also elsewhere on the board
/Signals & Sensors/A1_SIGNAL_G: JP13.1 (A), R59.1, U12.32 (PD2)
/Signals & Sensors/A1_SIGNAL_R: JP5.1 (A), R50.1, U12.30 (PD0)
/Signals & Sensors/A1_SIGNAL_Y: JP9.1 (A), R55.1, U12.31 (PD1)
/Signals & Sensors/A2_SIGNAL_G: JP25.1 (A), R71.1, U12.3 (PA2)
/Signals & Sensors/A2_SIGNAL_R: JP17.1 (A), R63.1, U12.1 (PD3)
/Signals & Sensors/A2_SIGNAL_Y: JP21.1 (A), R67.1, U12.2 (PD4)
/Signals & Sensors/B1_SIGNAL_G: JP14.1 (A), R60.1, U12.8 (PB7)
/Signals & Sensors/B1_SIGNAL_R: JP6.1 (A), R51.1, U12.6 (PA3)
/Signals & Sensors/B1_SIGNAL_Y: JP10.1 (A), R56.1, U12.7 (PB6)
/Signals & Sensors/B2_SIGNAL_G: JP26.1 (A), R72.1, U12.11 (PD7)
/Signals & Sensors/B2_SIGNAL_R: JP18.1 (A), R64.1, U12.9 (PD5)
/Signals & Sensors/B2_SIGNAL_Y: JP22.1 (A), R68.1, U12.10 (PD6)
/Signals & Sensors/C1_SIGNAL_G: JP15.1 (A), R61.1, U12.14 (PB2)
/Signals & Sensors/C1_SIGNAL_R: JP7.1 (A), R52.1, U12.12 (PB0)
/Signals & Sensors/C1_SIGNAL_Y: JP11.1 (A), R57.1, U12.13 (PB1)
/Signals & Sensors/C2_SIGNAL_G: J31.3 (SCK), JP27.1 (A), R73.1, U12.17 (PB5)
/Signals & Sensors/C2_SIGNAL_R: J31.4 (MOSI), JP19.1 (A), R65.1, U12.15 (PB3)
/Signals & Sensors/C2_SIGNAL_Y: J31.1 (MISO), JP23.1 (A), R69.1, U12.16 (PB4)
/Signals & Sensors/COM_SENSE: R54.1, U12.19 (PA0)
/Signals & Sensors/D1_SIGNAL_G: JP16.1 (A), R62.1, U12.23 (PC0)
/Signals & Sensors/D1_SIGNAL_R: JP8.1 (A), R53.1, U12.20 (PC7)
/Signals & Sensors/D1_SIGNAL_Y: JP12.1 (A), R58.1, U12.22 (PA1)
/Signals & Sensors/D2_SIGNAL_G: JP28.1 (A), R74.1, U12.26 (PC3)
/Signals & Sensors/D2_SIGNAL_R: JP20.1 (A), R66.1, U12.24 (PC1)
/Signals & Sensors/D2_SIGNAL_Y: JP24.1 (A), R70.1, U12.25 (PC2)
/Signals & Sensors/SENSOR_IN_0: J39.3, U13.4 (IO0_0)
/Signals & Sensors/SENSOR_IN_1: J38.3, U13.5 (IO0_1)
/Signals & Sensors/SENSOR_IN_2: J37.3, U13.6 (IO0_2)
/Signals & Sensors/SENSOR_IN_3: J36.3, U13.7 (IO0_3)
/Signals & Sensors/SENSOR_IN_4: J35.3, U13.8 (IO0_4)
/Signals & Sensors/SENSOR_IN_5: J34.3, U13.9 (IO0_5)
/Signals & Sensors/SENSOR_IN_6: J33.3, U13.10 (IO0_6)
/Signals & Sensors/SENSOR_IN_7: J32.3, U13.11 (IO0_7)
/Signals & Sensors/SENSOR_IN_8: J41.3, U13.13 (IO1_0)
/Signals & Sensors/SENSOR_IN_9: J40.3, U13.14 (IO1_1)
/Signals & Sensors/SENSOR_IN_10: J42.7, U13.15 (IO1_2)
/Signals & Sensors/SENSOR_IN_11: J42.6, U13.16 (IO1_3)
/Signals & Sensors/SENSOR_IN_12: J42.5, U13.17 (IO1_4)
/Signals & Sensors/SENSOR_IN_13: J42.4, U13.18 (IO1_5)
/Signals & Sensors/SENSOR_IN_14: J42.3, U13.19 (IO1_6)
/Signals & Sensors/SENSOR_IN_15: J42.2, U13.20 (IO1_7)
GND: C35.2, C36.2, J31.6 (GND), J32.1, J33.1, J34.1, J35.1, J36.1, J37.1, J38.1, J39.1, J40.1, J41.1, J42.1, SW3.3 (C), SW3.6 (C), U12.5 (GND), U12.21 (GND), U13.3 (A2), U13.12 (VSS), U13.21 (A0); also elsewhere on the board
unnamed: J11.1, J15.2, JP9.2 (B), R55.2
unnamed: J11.2, J15.3, JP13.2 (B), R59.2
unnamed: J11.3, J15.1, JP5.2 (B), R50.2
unnamed: J11.4, J11.MP (MountPin), J12.4, J12.MP (MountPin), J13.4, J13.MP (MountPin), J14.4, J14.MP (MountPin), J19.1, J19.2, J19.3, J21.1, J21.2, J21.3, J27.4, J27.MP (MountPin), J28.4, J28.MP (MountPin), J29.4, J29.MP (MountPin), J30.4, J30.MP (MountPin), R54.2, SW3.2 (B), SW3.5 (B), TP3.1
unnamed: J12.1, J16.2, JP10.2 (B), R56.2
unnamed: J12.2, J16.3, JP14.2 (B), R60.2
unnamed: J12.3, J16.1, JP6.2 (B), R51.2
unnamed: J13.1, J17.2, JP11.2 (B), R57.2
unnamed: J13.2, J17.3, JP15.2 (B), R61.2
unnamed: J13.3, J17.1, JP7.2 (B), R52.2
unnamed: J14.1, J18.2, JP12.2 (B), R58.2
unnamed: J14.2, J18.3, JP16.2 (B), R62.2
unnamed: J14.3, J18.1, JP8.2 (B), R53.2
unnamed: J23.1, J27.3, JP17.2 (B), R63.2
unnamed: J23.2, J27.1, JP21.2 (B), R67.2
unnamed: J23.3, J27.2, JP25.2 (B), R71.2
unnamed: J24.1, J28.3, JP18.2 (B), R64.2
unnamed: J24.2, J28.1, JP22.2 (B), R68.2
unnamed: J24.3, J28.2, JP26.2 (B), R72.2
unnamed: J25.1, J29.3, JP19.2 (B), R65.2
unnamed: J25.2, J29.1, JP23.2 (B), R69.2
unnamed: J25.3, J29.2, JP27.2 (B), R73.2
unnamed: J26.1, J30.3, JP20.2 (B), R66.2
unnamed: J26.2, J30.1, JP24.2 (B), R70.2
unnamed: J26.3, J30.2, JP28.2 (B), R74.2
unnamed: J31.5 (~RESET), R75.2, U12.29 (~RESET/PC6)
SCL: U12.28 (PC5), U13.22 (SCL); also elsewhere on the board
SDA: U12.27 (PC4), U13.23 (SDA); also elsewhere on the board

Notes on the sheet:
Atlas Signal Connector for Signal C Lower Molex Picoblade 1 - Yellow 2 - Green 3 - Red 4 - Common
Signal B-Lower - Green LED
Signal C-Lower - Red LED
Signal C/D Common Terminal
Signal C-Upper - Red LED
Signal C-Upper - Green LED
Signal D-Upper - Yellow LED
Signal D-Lower - Red LED
Signal C-Lower - Green LED
Signal D-Upper - Red LED
Signal B-Upper - Green LED
Signal A-Upper - Yellow LED
Signal C-Upper - Yellow LED
Signal B-Upper - Red LED
Atlas Signal Connector for Signal D Lower Molex Picoblade 1 - Yellow 2 - Green 3 - Red 4 - Common
Atlas Signal Connector for Signal B Upper Molex Picoblade 1 - Yellow 2 - Green 3 - Red 4 - Common
Atlas Signal Connector for Signal A Upper Molex Picoblade 1 - Yellow 2 - Green 3 - Red 4 - Common
Atlas Signal Connector for Signal D Upper Molex Picoblade 1 - Yellow 2 - Green 3 - Red 4 - Common
Signal D-Lower - Yellow LED
Atlas Signal Connector for Signal B Lower Molex Picoblade 1 - Yellow 2 - Green 3 - Red 4 - Common
Signal A/B Common Terminal
Atlas Signal Connector for Signal A Lower Molex Picoblade 1 - Yellow 2 - Green 3 - Red 4 - Common
Signal D-Upper - Green LED
Signal D-Lower - Green LED
7-Bit I2C Addr = 0x22
Signal C-Lower - Yellow LED
Signal A-Upper - Red LED
Signal B-Lower - Yellow LED
Signal A-Lower - Yellow LED
Signal A-Lower - Green LED
Signal A-Lower - Red LED
Signal B-Lower - Red LED
Signal B-Upper - Yellow LED
Common Anode / Common Cathode Selector Switch
Atlas Signal Connector for Signal C Upper Molex Picoblade 1 - Yellow 2 - Green 3 - Red 4 - Common
Signal A-Upper - Green LED

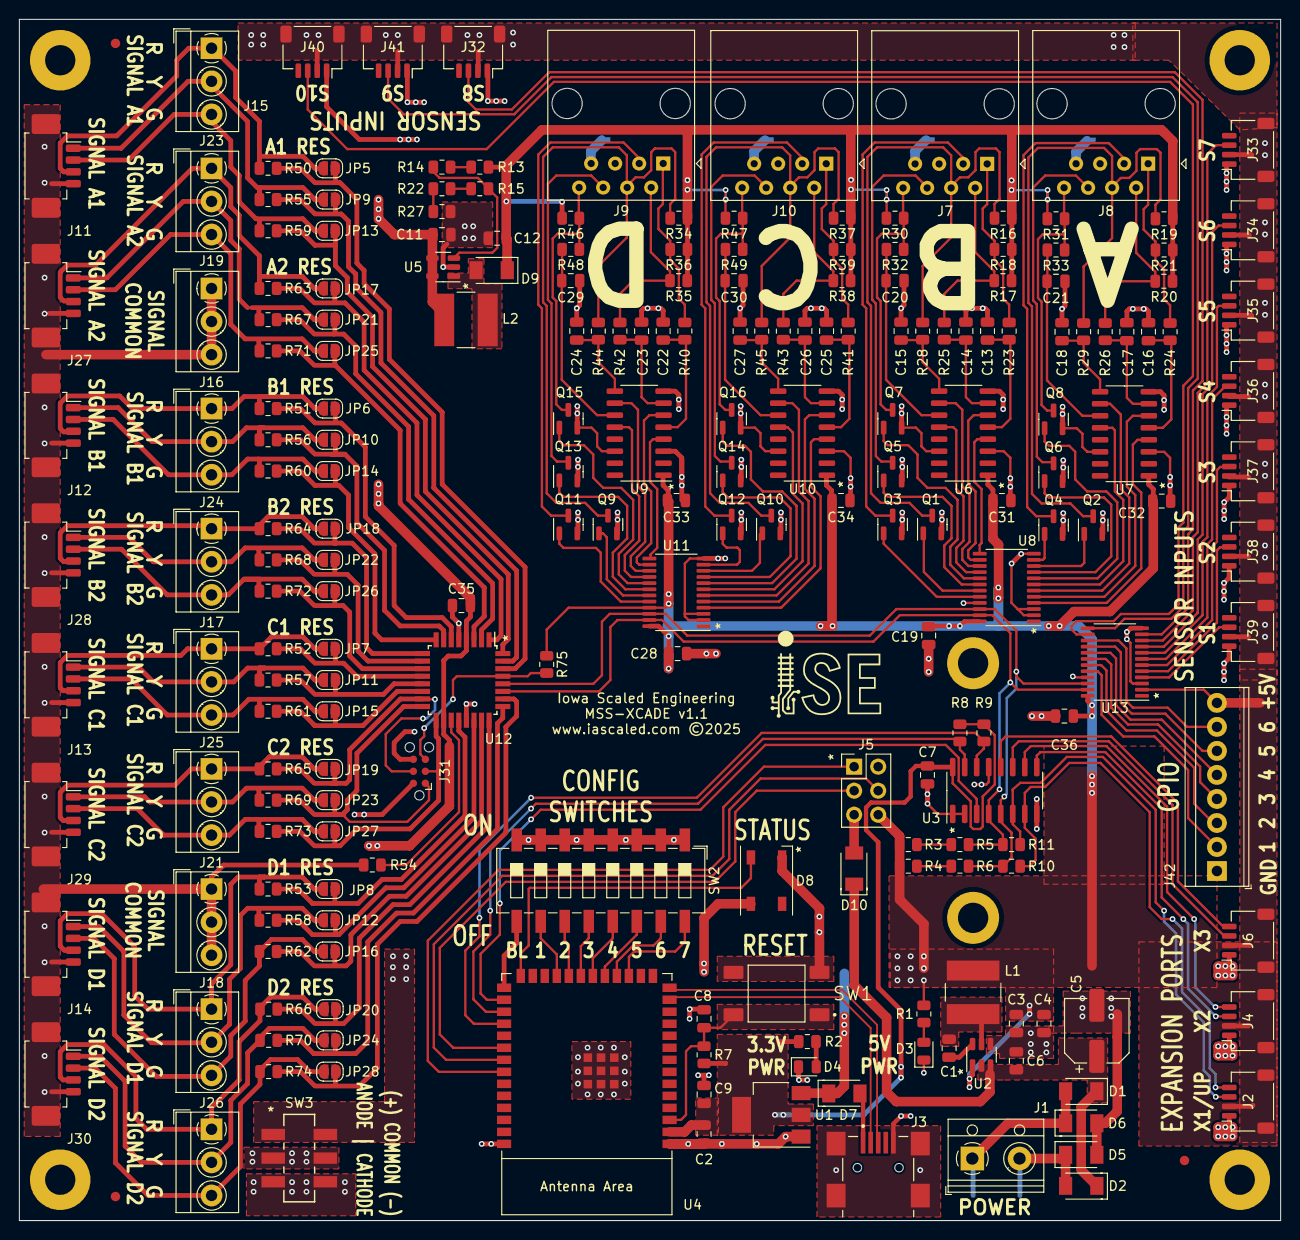
[picture p8: board mss-xcade.kicad_pcb from above]

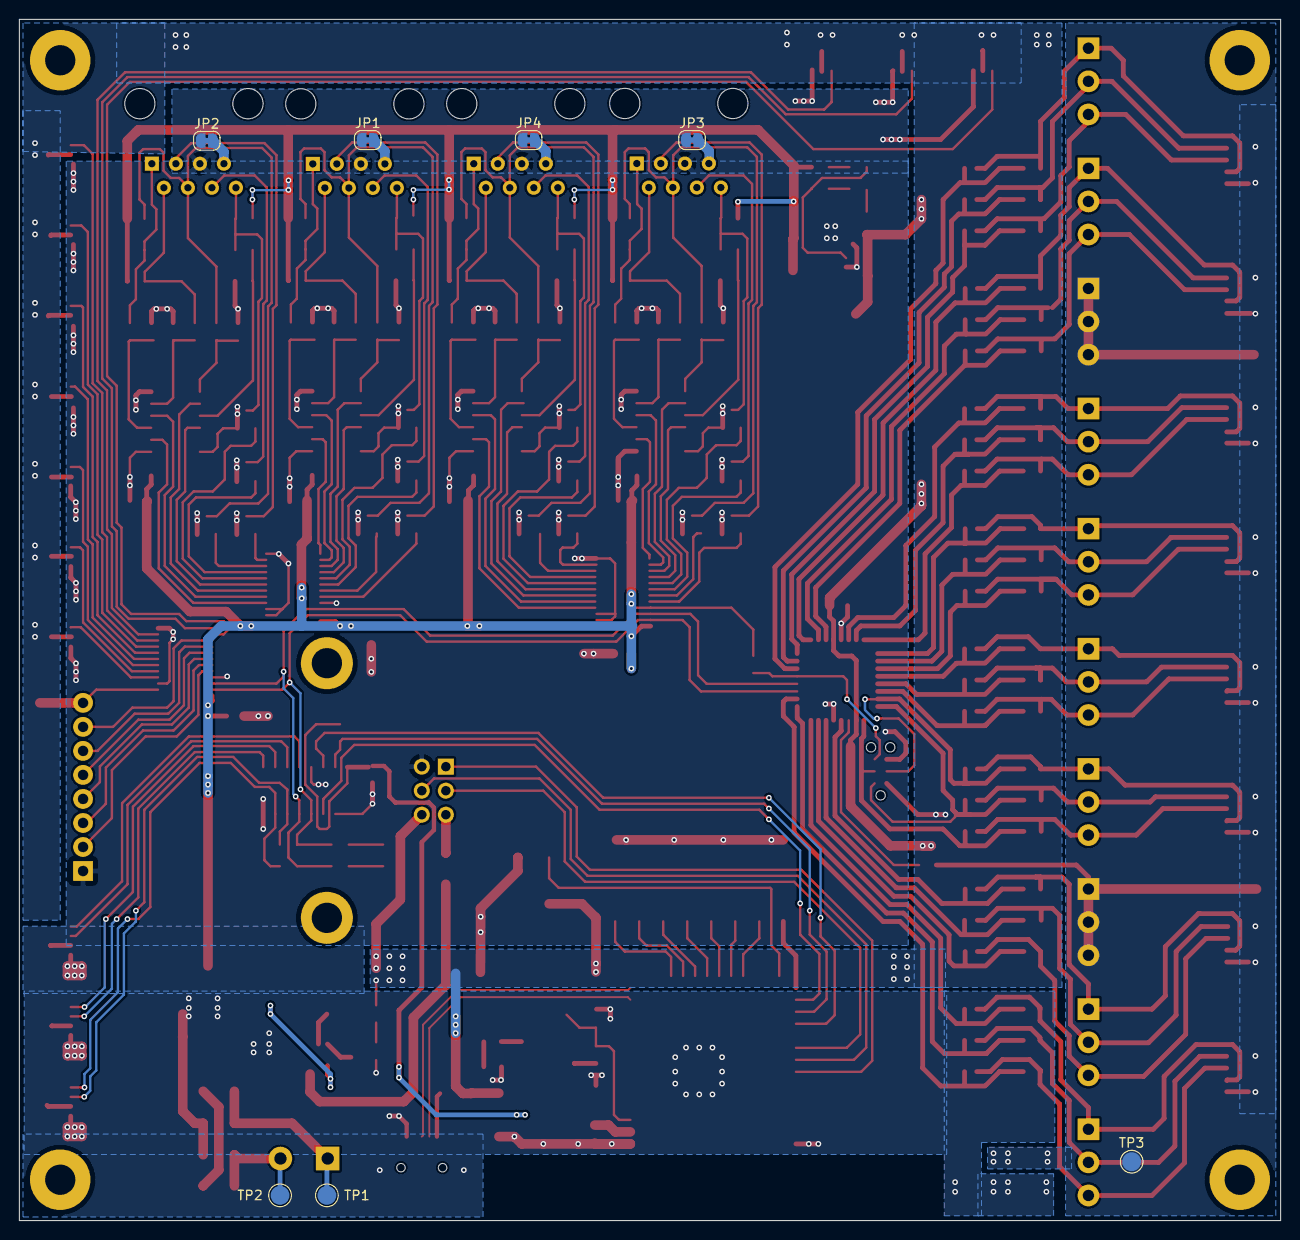
[picture p9: board mss-xcade.kicad_pcb from below]

Board: 2 copper layers, 133.4 x 127.0 mm, 233 parts (7 on the bottom side), 189 nets.
