IowaScaledEngineering/mss-xcade/kicad/mss-xcade-can/mss-xcade-can.kicad_pcb

## KiCad design kicad/mss-xcade-can/mss-xcade-can.kicad_pcb (2025-04-04)

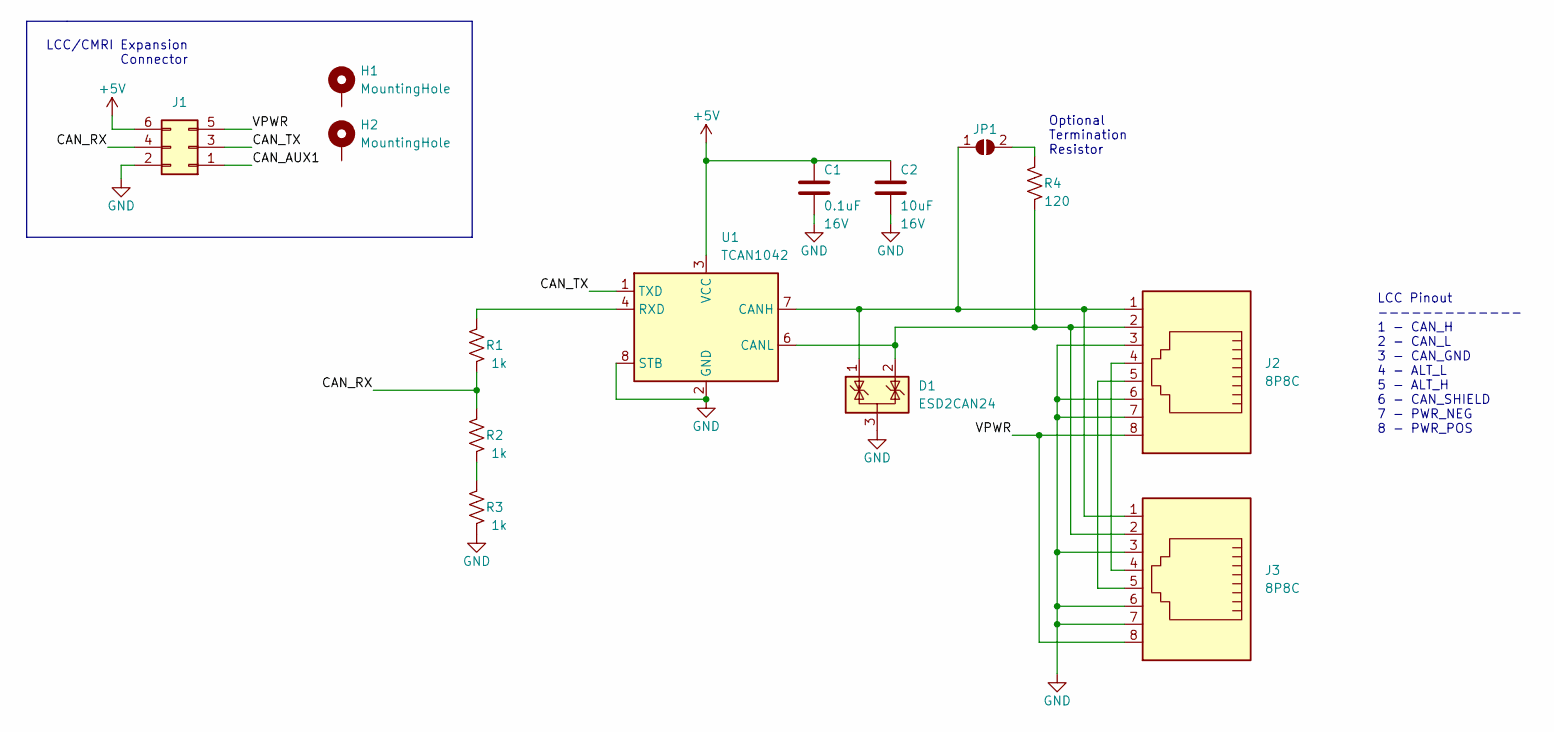
[picture p10: schematic mss-xcade-can.kicad_sch, MSS Cascade Advanced CAN Board]

Parts:
C1: 0.1uF; C_0805_2012Metric; Voltage 16V
C2: 10uF; C_0805_2012Metric; Voltage 16V
D1: ESD2CAN24; SOT-23
H1, H2: MountingHole; MountingHole_3.2mm_M3_ISO14580_Pad
J1: Conn_02x03_Odd_Even; PinHeader_2x03_P2.54mm_Vertical
J2, J3: 8P8C; RJ45_Amphenol_54602-x08_Horizontal
JP1: SolderJumper_2_Open; SolderJumper-2_P1.3mm_Open_RoundedPad1.0x1.5mm
R1, R2, R3: 1k; R_0805_2012Metric
R4: 120; R_0805_2012Metric
U1: TCAN1042; SOIC-8_3.9x4.9mm_P1.27mm

Connections:
+5V: C1.1, C2.1, J1.6, U1.3 (VCC)
/CAN_AUX1: J1.1
/CAN_RX: J1.4, R1.1, R2.2
/CAN_TX: J1.3, U1.1 (TXD)
/VPWR: J1.5, J2.8, J3.8
GND: C1.2, C2.2, D1.3 (A), J1.2, J2.3, J2.6, J2.7, J3.3, J3.6, J3.7, R3.1, U1.2 (GND), U1.8 (STB)
unnamed: D1.1 (K), J2.1, J3.1, JP1.1 (A), U1.7 (CANH)
unnamed: D1.2 (K), J2.2, J3.2, R4.1, U1.6 (CANL)
unnamed: J2.4, J3.4
unnamed: J2.5, J3.5
unnamed: JP1.2 (B), R4.2
unnamed: R1.2, U1.4 (RXD)
unnamed: R2.1, R3.2

Notes on the sheet:
LCC/CMRI Expansion Connector
Optional Termination Resistor
LCC Pinout ------------- 1 - CAN_H 2 - CAN_L 3 - CAN_GND 4 - ALT_L 5 - ALT_H 6 - CAN_SHIELD 7 - PWR_NEG 8 - PWR_POS

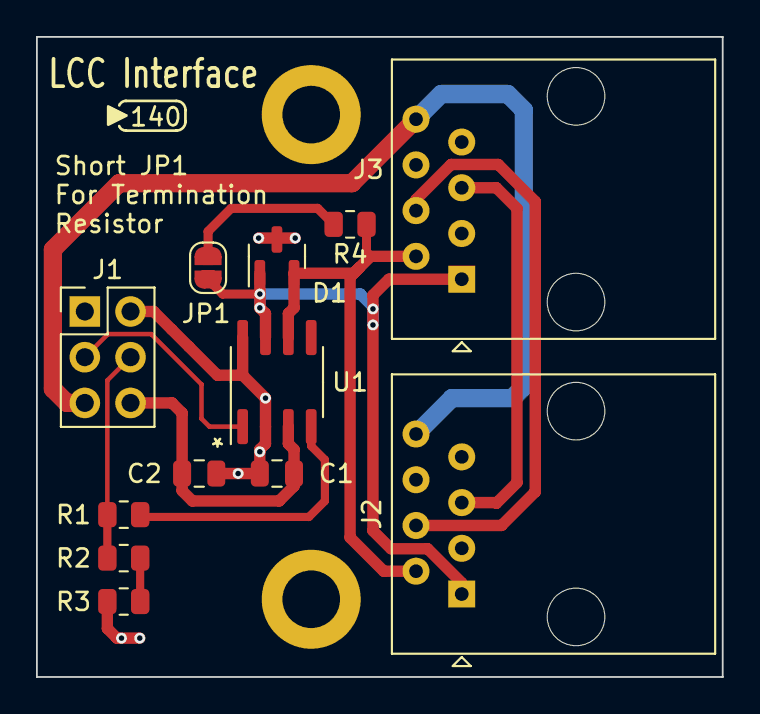
[picture p11: board mss-xcade-can.kicad_pcb from above]

Board: 2 copper layers, 38.1 x 35.6 mm, 14 parts (0 on the bottom side), 12 nets.
