IowaScaledEngineering/mss-xcade/src/i2c-shcp/i2c-shcp.c

/*************************************************************************
Title:    I2C-SHCP (Signal Head Co-Processor)
Authors:  Michael Petersen <railfan@drgw.net>
          Nathan D. Holmes <maverick@drgw.net>
File:     $Id: $
License:  GNU General Public License v3

LICENSE:
    Copyright (C) 2025 Michael Petersen & Nathan Holmes

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
*************************************************************************/

#include <avr/io.h>
#include <avr/interrupt.h>
#include <avr/wdt.h>
#include <util/delay.h>
#include <util/atomic.h>

#include <avr/sleep.h>
#include <stdbool.h>
#include <stdint.h>

#include "avr-i2c-slave.h"
#include "debouncer.h"
#include "signalHead.h"

#define LOOP_UPDATE_TIME_MS       50
#define STARTUP_LOCKOUT_TIME_MS  500

#define MIN(a,b) ((a)<(b)?(a):(b))
#define MAX(a,b) ((a)>(b)?(a):(b))

volatile uint32_t millis = 0;

#define MAX_SIGNAL_HEADS 8
SignalState_t signal[MAX_SIGNAL_HEADS];
volatile uint8_t signalHeadOptions[MAX_SIGNAL_HEADS];

#define I2C_REGISTER_MAP_SIZE  24
volatile uint8_t i2c_registerMap[I2C_REGISTER_MAP_SIZE];
volatile uint8_t i2c_registerAttributes[I2C_REGISTER_MAP_SIZE];
const uint8_t i2c_registerMapSize= I2C_REGISTER_MAP_SIZE;


// A few hardware definitions
// Signal Port Connections
// These are in the order of:
//  Red address, bitmask
//  Yellow address, bitmask
//  Green address, bitmask

#define SIGNAL_HEAD_0_DEF   &PORTD, _BV(PD0), &PORTD, _BV(PD1), &PORTD, _BV(PD2)
#define SIGNAL_HEAD_1_DEF   &PORTD, _BV(PD3), &PORTD, _BV(PD4), &PORTA, _BV(PA2)
#define SIGNAL_HEAD_2_DEF   &PORTA, _BV(PA3), &PORTB, _BV(PB6), &PORTB, _BV(PB7)
#define SIGNAL_HEAD_3_DEF   &PORTD, _BV(PD5), &PORTD, _BV(PD6), &PORTD, _BV(PD7)
#define SIGNAL_HEAD_4_DEF   &PORTB, _BV(PB0), &PORTB, _BV(PB1), &PORTB, _BV(PB2)
#define SIGNAL_HEAD_5_DEF   &PORTB, _BV(PB3), &PORTB, _BV(PB4), &PORTB, _BV(PB5)
#define SIGNAL_HEAD_6_DEF   &PORTC, _BV(PC7), &PORTA, _BV(PA1), &PORTC, _BV(PC0)
#define SIGNAL_HEAD_7_DEF   &PORTC, _BV(PC1), &PORTC, _BV(PC2), &PORTC, _BV(PC3)

#define SENSE_COMMON_ANODE 0x01

#define OPTION_COMMON_CATHODE  0x80
#define OPTION_COMMON_ANODE    0x40
#define OPTION_CA_CC_SENSE     0x00

#define OPTION_SIGNAL_THREE_LIGHT 0x00
#define OPTION_SIGNAL_SEARCHLIGHT 0x01

#define I2CREG_ASPECTS_BASE   0
#define I2CREG_OPTIONS_BASE   8


uint32_t getMillis()
{
	uint32_t retmillis;
	ATOMIC_BLOCK(ATOMIC_RESTORESTATE) 
	{
		retmillis = millis;
	}
	return retmillis;
}

volatile uint8_t flasher = 0;
volatile bool updateSignals = false;

ISR(TIMER0_COMPA_vect) 
{
	static uint8_t flasherCounter = 0;
	static uint8_t pwmPhase = 0;
	static uint8_t subMillisCounter = 0;
	
	// The ISR does two main things - updates the LED outputs since
	//  PWM is done through software, and updates millis which is used
	//  to trigger various events
	// We need this to run at roughly 125 Hz * number of PWM levels (32).  That makes a nice round 4kHz
	
	// First thing, output the signals so that the PWM doesn't get too much jitter

	signalHeadISR_OutputPWM(&signal[0], signalHeadOptions[0], pwmPhase, SIGNAL_HEAD_0_DEF);
	signalHeadISR_OutputPWM(&signal[1], signalHeadOptions[1], pwmPhase, SIGNAL_HEAD_1_DEF);
	signalHeadISR_OutputPWM(&signal[2], signalHeadOptions[2], pwmPhase, SIGNAL_HEAD_2_DEF);
	signalHeadISR_OutputPWM(&signal[3], signalHeadOptions[3], pwmPhase, SIGNAL_HEAD_3_DEF);
	signalHeadISR_OutputPWM(&signal[4], signalHeadOptions[4], pwmPhase, SIGNAL_HEAD_4_DEF);
	signalHeadISR_OutputPWM(&signal[5], signalHeadOptions[5], pwmPhase, SIGNAL_HEAD_5_DEF);
	signalHeadISR_OutputPWM(&signal[6], signalHeadOptions[6], pwmPhase, SIGNAL_HEAD_6_DEF);
	signalHeadISR_OutputPWM(&signal[7], signalHeadOptions[7], pwmPhase, SIGNAL_HEAD_7_DEF);

	// Now do all the counter incrementing and such
	if (++subMillisCounter >= 4)
	{
		subMillisCounter = 0;
		millis++;
	}

	pwmPhase = (pwmPhase + 1) & 0x1F;

	if (0 == pwmPhase)
	{
		pwmPhase = 0;
		flasherCounter++;
		if (flasherCounter > 94)
		{
			flasher ^= 0x01;
			flasherCounter = 0;
		}

		// We rolled over the PWM counter, calculate the next PWM widths
		// This runs at 125 frames/second essentially
		updateSignals = true;
	}
}

void initializeTimer()
{
	TIMSK0 = 0;           // Timer interrupts OFF

	// Set up Timer/Counter0 for 100Hz clock
	TCCR0A = 0b00001010;  // CTC Mode
	                      // CS01 - 1:8 prescaler
	OCR0A = 250;          // 8MHz / 8 / 250 = 4kHz
	TIMSK0 = _BV(OCIE0A);
}

void initializeRegisterMap()
{
	for(uint8_t i=0; i<I2C_REGISTER_MAP_SIZE; i++)
	{
		i2c_registerMap[i] = i2c_registerAttributes[i] = 0;
	}
}

void initializeI2C()
{
	initializeRegisterMap();
	i2cSlaveInitialize(0x40, false);
}

void initializeOptions(DebounceState8_t* optionsDebouncer)
{
	// Basically the only thing the debouncer cares about is the common anode / common cathode
	//  sense line that's on PINA:0
	initDebounceState8(optionsDebouncer, (PINA & 0x01)?OPTION_COMMON_ANODE:0);
}

void readOptions(DebounceState8_t* optionsDebouncer)
{
	debounce8((PINA & 0x01)?OPTION_COMMON_ANODE:0, optionsDebouncer);
}

int main(void)
{
	DebounceState8_t optionsDebouncer;
	uint32_t lastReadTime = 0;
	uint32_t currentTime = 0;
	uint8_t i=0;
	uint8_t defaultSignalHeadOptions = SIGNAL_OPTION_COMMON_ANODE;
	// Deal with watchdog first thing
	MCUSR = 0;              // Clear reset status
	wdt_reset();            // Reset the WDT, just in case it's still enabled over reset
	wdt_enable(WDTO_1S);    // Enable it at a 1S timeout.

	// PORT A
	//  PA7 - n/a
	//  PA6 - n/a
	//  PA5 - n/a
	//  PA4 - n/a
	//  PA3 - Input  - B1 Signal - RED
	//  PA2 - Input  - A2 Signal - GREEN
	//  PA1 - Output - D1 Signal - YELLOW
	//  PA0 - Input  - Common anode / common cathode sense (1 = common anode)

	// PORT B
	//  PB7 - Output - B1 Signal - GREEN
	//  PB6 - Output - B1 Signal - YELLOW
	//  PB5 - Output - C2 Signal - GREEN
	//  PB4 - Output - C2 Signal - YELLOW
	//  PB3 - Output - C2 Signal - RED
	//  PB2 - Output - C1 Signal - GREEN
	//  PB1 - Output - C1 Signal - YELLOW
	//  PB0 - Output - C1 Signal - RED

	// PORT C
	//  PC7 - Output - D1 Signal - RED
	//  PC6 - n/a    - /RESET (not I/O pin)
	//  PC5 - n/a    - SCL
	//  PC4 - n/a    - SDA
	//  PC3 - Output - D2 Signal - GREEN
	//  PC2 - Output - D2 Signal - YELLOW
	//  PC1 - Output - D2 Signal - RED
	//  PC0 - Output - D1 Signal - GREEN

	// PORT D
	//  PD7 - Output - B2 Signal - GREEN
	//  PD6 - Output - B2 Signal - YELLOW
	//  PD5 - Output - B2 Signal - RED
	//  PD4 - Output - A2 Signal - YELLOW
	//  PD3 - Output - A2 Signal - RED
	//  PD2 - Output - A1 Signal - GREEN
	//  PD1 - Output - A1 Signal - YELLOW
	//  PD0 - Output - A1 Signal - RED


	PORTA = 0b00000001;
	DDRA  = 0b00001110;

	PORTB = 0b00000000;
	DDRB  = 0b11111111;

	PORTC = 0b00110000;
	DDRC  = 0b10001111;

	PORTD = 0b00000000;
	DDRD  = 0b11111111;

	initializeTimer();
	initializeI2C();
	initializeOptions(&optionsDebouncer);

	if (getDebouncedState(&optionsDebouncer) & SENSE_COMMON_ANODE)
		defaultSignalHeadOptions |= SIGNAL_OPTION_COMMON_ANODE;

	for(i=0; i<MAX_SIGNAL_HEADS; i++)
	{
		signalHeadInitialize(&signal[i]);
		signalHeadAspectSet(&signal[i], ASPECT_OFF);
		signalHeadOptions[i] = defaultSignalHeadOptions;
	}

	sei();
	wdt_reset();

	while(1)
	{
		wdt_reset();

		if (updateSignals)
		{
			updateSignals = false;
			for (uint8_t i=0; i<MAX_SIGNAL_HEADS; i++)
				signalHeadISR_AspectToNextPWM(&signal[i], flasher, signalHeadOptions[i]);
		}

		currentTime = getMillis();

		// Because debouncing and such is built into option reading and the MSS library, only 
		//  run the updates every 10mS or so.

		if (((uint32_t)currentTime - lastReadTime) > LOOP_UPDATE_TIME_MS && !(i2cBusy()))
		{
			bool caSense = false;
			lastReadTime = currentTime;
			readOptions(&optionsDebouncer);
			if (getDebouncedState(&optionsDebouncer) & OPTION_COMMON_ANODE)
				caSense = true;

			for(i=0; i<MAX_SIGNAL_HEADS; i++)
			{
				uint8_t optionsReg = i2c_registerMap[I2CREG_OPTIONS_BASE+i];
				uint8_t optionsTemp = 0;
				switch(optionsReg & 0xC0)
				{
					case OPTION_COMMON_ANODE:
						optionsTemp |= SIGNAL_OPTION_COMMON_ANODE;
						break;

					case OPTION_CA_CC_SENSE:
						optionsTemp |= (caSense)?SIGNAL_OPTION_COMMON_ANODE:0;
						break;

					case OPTION_COMMON_CATHODE:
					default:
						break;
				}

				switch (optionsReg & 0x07)
				{
					case OPTION_SIGNAL_THREE_LIGHT:
						break;

					case OPTION_SIGNAL_SEARCHLIGHT:
						optionsTemp |= SIGNAL_OPTION_SEARCHLIGHT;
						break;

					default:
						break;
				}

				signalHeadOptions[i] = optionsTemp;
				signalHeadAspectSet(&signal[i], i2c_registerMap[I2CREG_ASPECTS_BASE+i]);
			}
		}
	}
}
