IowaScaledEngineering/mss-xcade/(commit log)

2024-08-11 Work in progress
    [mss-xcade-interface.kicad_sch, mss-xcade.kicad_pcb, mss-xcade.kicad_sch]
2024-08-11 More updates
    [mss-xcade-interface.kicad_sch, mss-xcade.kicad_sch]
2024-08-29 Temporarily add the relay siding end thingy
    [mss-siding-basic.kicad_pcb, mss-siding-basic.kicad_sch]
2024-09-03 Add draft siding truth table to this directory for now - need to split the whole thing into its own project
    [Siding Truth Tables.ods]
2024-09-03 xcade upates
    [mss-xcade.kicad_sch, mss-xcade.ods]
2024-11-26 Refactor signal drivers to their own schematic and add picoblade connectors
    [mss-xcade-interface.kicad_sch, mss-xcade-signal-drivers.kicad_sch, mss-xcade.kicad_sch]
2025-03-03 First cut of xcade PCB
    [Siding Truth Tables.ods, mss-siding-basic.kicad_pcb, mss-siding-basic.kicad_sch, mss-xcade-interface.kicad_sch, mss-xcade-signal-drivers.kicad_sch, mss-xcade.kicad_pcb, mss-xcade.kicad_sch]
2025-03-29 Update expansion connector and add CAN interface module board
    [mss-xcade-can.kicad_pcb, mss-xcade-can.kicad_sch, mss-xcade.kicad_pcb, mss-xcade.kicad_sch]
2025-04-04 Fix a DRC issue and add some more metal
    [mss-xcade.kicad_pcb]
2025-04-04 Add optional termination resistor
    [mss-xcade-can.kicad_pcb, mss-xcade-can.kicad_sch]
2025-04-18 Fix issue with pin mapping and DDR, update comments
    [i2c-shcp.c]
2025-05-08 Fix issue with signal D1 not having green setup correctly
    [i2c-shcp.c]
2025-05-14 Move some heavy processing outside the ISR to make I2C more responsive, hopefully
2025-05-21 Tada! Missing pg files
    [mss-xcade-NPTH.drl, mss-xcade-can-NPTH.drl, mss-xcade-can.drl, mss-xcade-can.gbl, mss-xcade-can.gbo, mss-xcade-can.gbp, mss-xcade-can.gbr, mss-xcade-can.gbs]
2025-08-10 Hardware test arduino sketch
2025-08-19 Fix anode/cathode text, update version number
    [mss-xcade.kicad_pcb]
2026-06-09 Allow SHCP to recover from I2C fault
2026-06-19 PG 1.1
    [mss-xcade-NPTH.drl, mss-xcade.drl, mss-xcade.gbl, mss-xcade.gbo, mss-xcade.gbp, mss-xcade.gbr, mss-xcade.gbs, mss-xcade.gm1]
