IowaScaledEngineering/mss-xcade/(notices)

Notices in the files:
kicad/mss-xcade-can/mss-xcade-can.kicad_pcb:
www.iascaled.com ©2025
